CoolNamesAllTaken/kicad-libs/README.md

# kicad-libs
Custom components (symbols, footprints, 3d models) aggregated for KiCAD EDA.
