CoolNamesAllTaken/kicad-libs/stackups/jlcpcb_6layer_1.6mm_1oz_0.5oz_jlc06161h-7628.png

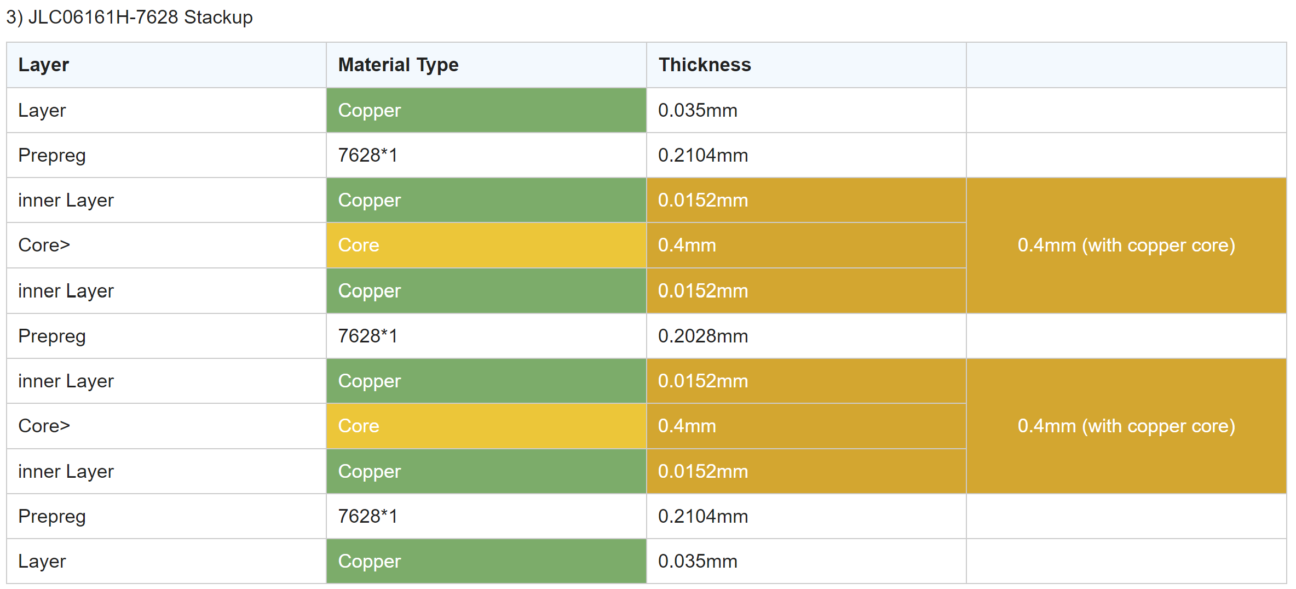
stackups/jlcpcb_6layer_1.6mm_1oz_0.5oz_jlc06161h-7628.png
