CoolNamesAllTaken/kicad-libs/lib_3d/Custom_Battery/LiPo 6060100.step

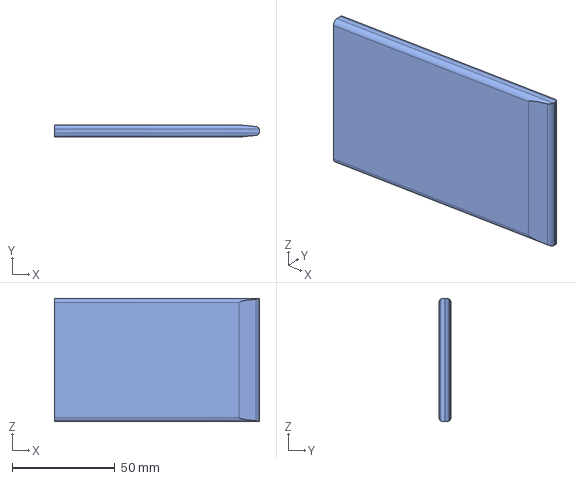
[picture p2: CAD file, 2026-04-22]
lib_3d/Custom_Battery/LiPo 6060100.step
100.0 x 6.00 x 60.0 mm
