CoolNamesAllTaken/kicad-libs/lib_3d/Custom_Button_Switch_SMD/Membrane Button Rect 3.step

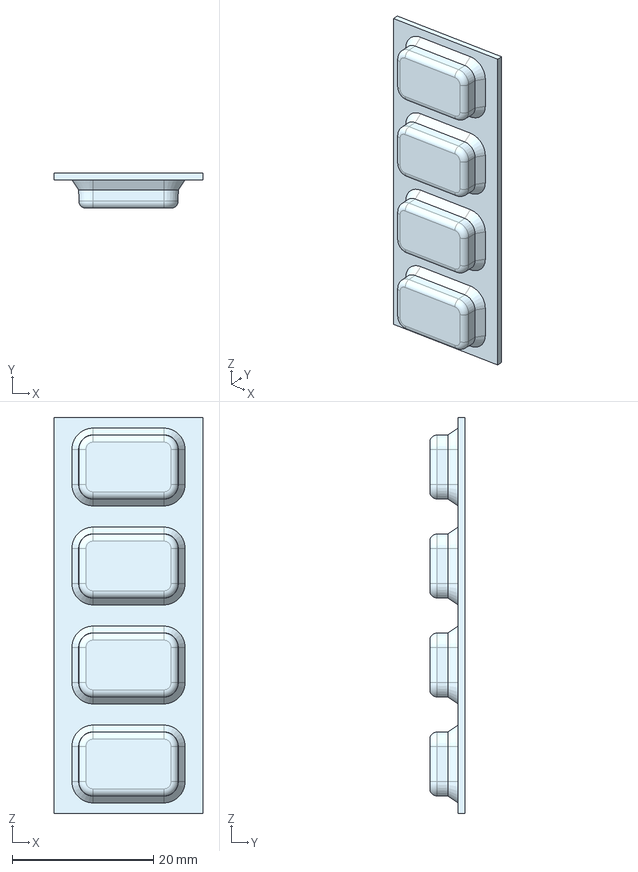
[picture p3: CAD file, 2026-04-22]
lib_3d/Custom_Button_Switch_SMD/Membrane Button Rect 3.step
21.0 x 5.00 x 56.0 mm
