CoolNamesAllTaken/kicad-libs/lib_3d/Custom_Connector/FTSH-105-01-L-DV-K.stp

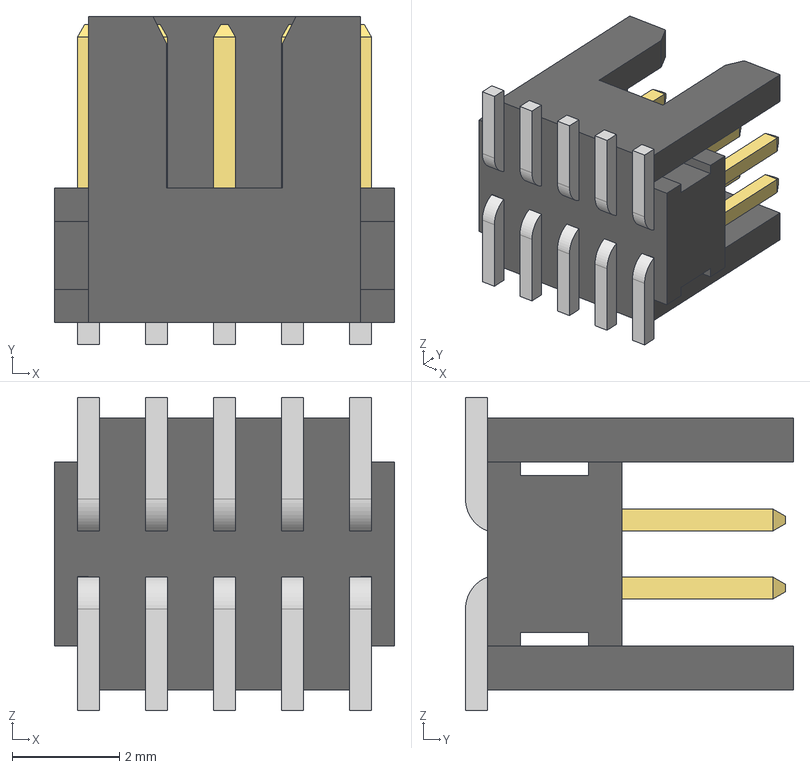
[picture p4: CAD file, 2026-06-26]
lib_3d/Custom_Connector/FTSH-105-01-L-DV-K.stp
6.35 x 6.12 x 5.84 mm
FTSH-105-01-L-DV-K_body
FTSH-105-01-L-DV-K_pins1
FTSH-105-01-L-DV-K_pins2
