CoolNamesAllTaken/kicad-libs/lib_3d/Custom_Connector_Audio/Boom_PJ-320B.step

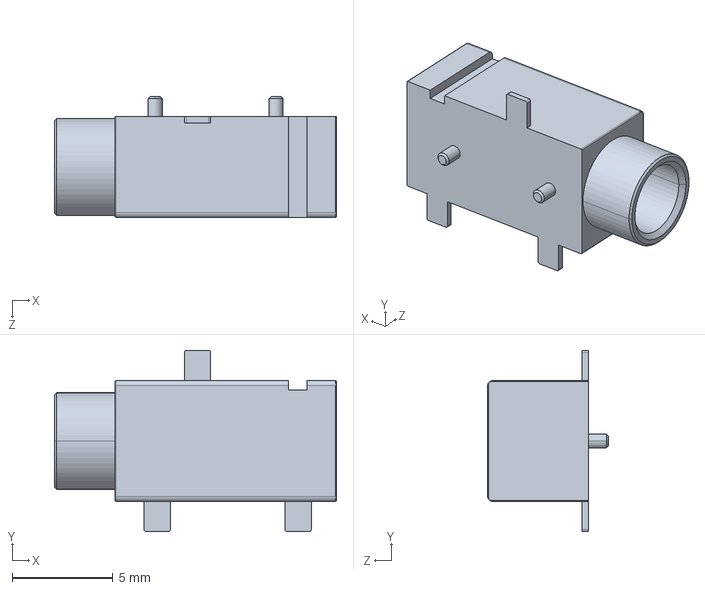
[picture p5: CAD file, 2022-11-25]
lib_3d/Custom_Connector_Audio/Boom_PJ-320B.step
14.0 x 9.00 x 6.00 mm
