CoolNamesAllTaken/kicad-libs/lib_3d/Custom_Connector_BarrelJack/SOFNG_DC005-T20.step

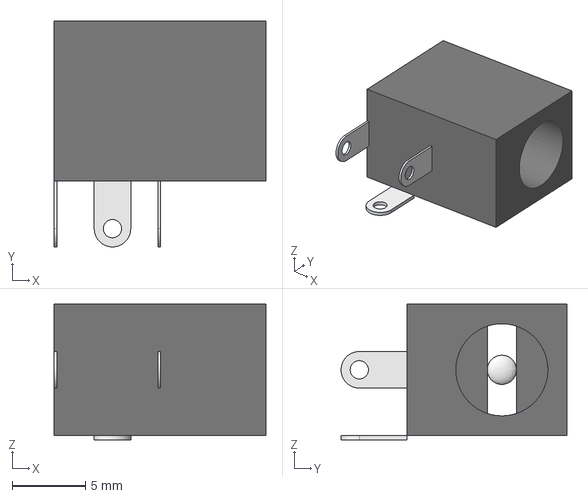
[picture p6: CAD file, 2022-11-25]
lib_3d/Custom_Connector_BarrelJack/SOFNG_DC005-T20.step
14.5 x 15.4 x 9.30 mm
