CoolNamesAllTaken/kicad-libs/lib_3d/Custom_Connector_Card/micro-sd-card-dummy.step

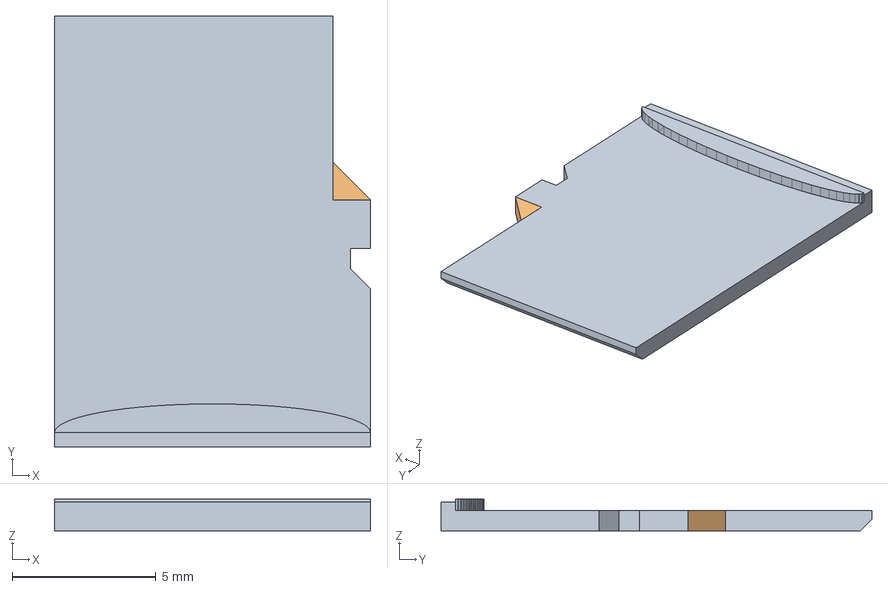
[picture p7: CAD file, 2026-04-22]
lib_3d/Custom_Connector_Card/micro-sd-card-dummy.step
11.0 x 15.0 x 1.10 mm
