CoolNamesAllTaken/kicad-libs/lib_3d/Custom_Connector_Coaxial/SMA_Amphenol_132255-11_EdgeMount.stp

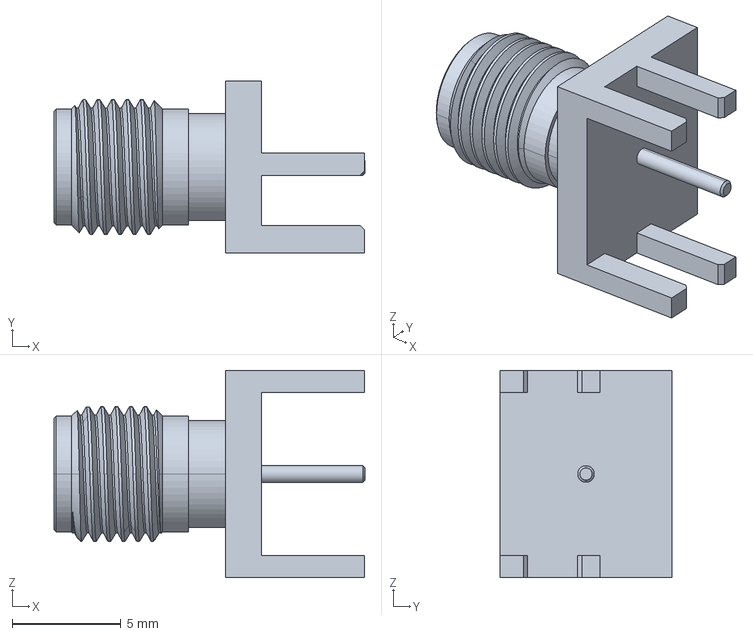
[picture p8: CAD file, 2023-06-24]
lib_3d/Custom_Connector_Coaxial/SMA_Amphenol_132255-11_EdgeMount.stp
14.3 x 7.92 x 9.52 mm
