CoolNamesAllTaken/kicad-libs/lib_3d/Custom_Connector_FFC-FPC/FPC-SMD_5P-P0.50_HCTL_HC-FPC-05-10-5RLTAG.step

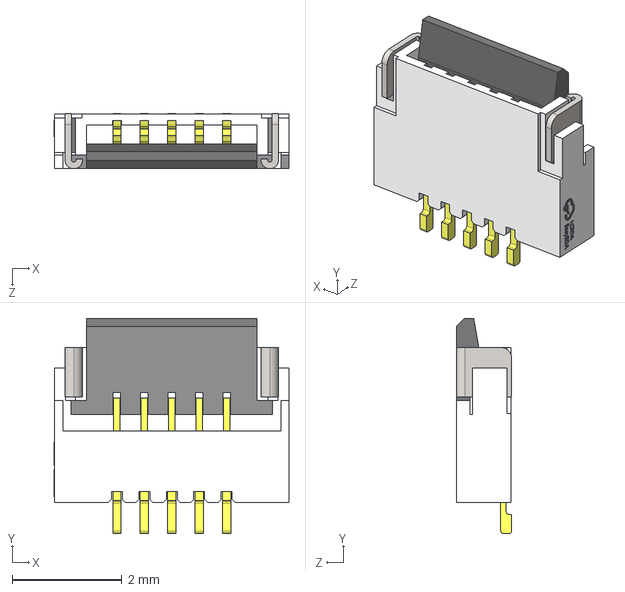
[picture p9: CAD file, 2026-05-06]
lib_3d/Custom_Connector_FFC-FPC/FPC-SMD_5P-P0.50_HCTL_HC-FPC-05-10-5RLTAG.step
4.28 x 3.92 x 1.01 mm
