CoolNamesAllTaken/kicad-libs/lib_3d/Custom_Connector_Hirose/Hirose_DF40HC(3.5)-30DS-0.4V(51)_P0.4mm_Vertical.stp

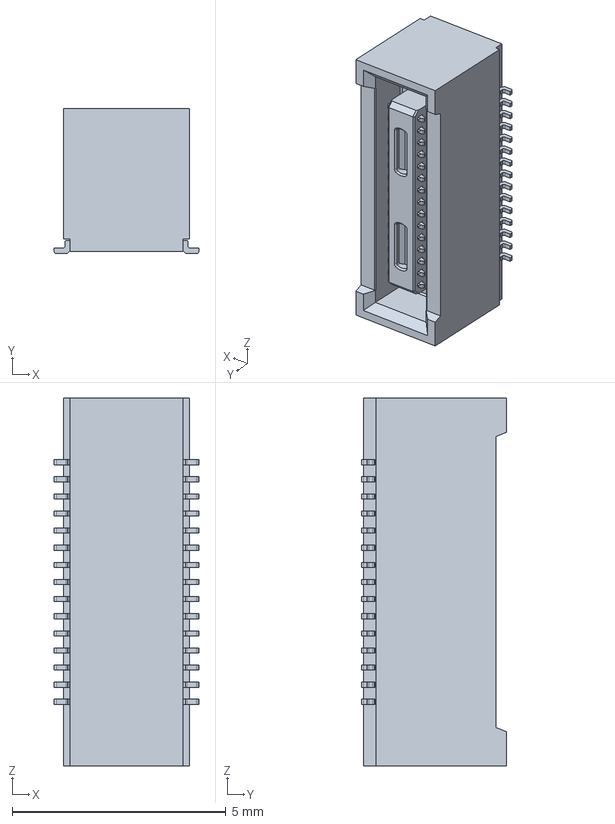
[picture p10: CAD file, 2024-07-10]
lib_3d/Custom_Connector_Hirose/Hirose_DF40HC(3.5)-30DS-0.4V(51)_P0.4mm_Vertical.stp
3.38 x 3.40 x 8.60 mm
