CoolNamesAllTaken/kicad-libs/lib_3d/Custom_Connector_JST/SM03B-PASS-TBT.step

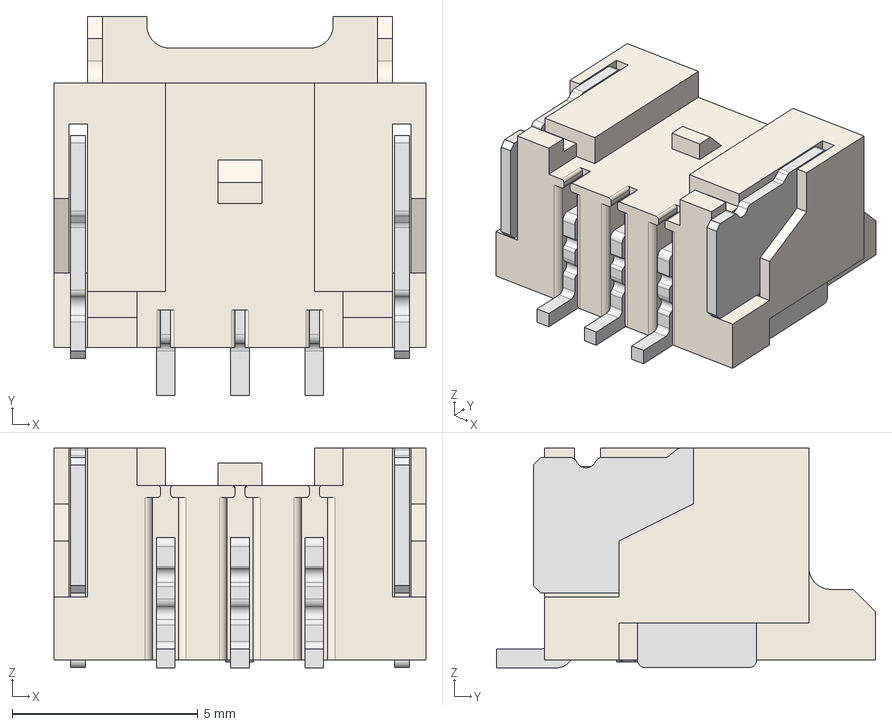
[picture p11: CAD file, 2026-04-22]
lib_3d/Custom_Connector_JST/SM03B-PASS-TBT.step
10.0 x 10.2 x 5.91 mm
CONN-SMD_SM03B-PASS-TBT~CONN-SMD_SM03B-PASS-TBT~jsbc
CONN-SMD_SM03B-PASS-TBT~CONN-SMD_SM03B-PASS-TBT~jsbc001
CONN-SMD_SM03B-PASS-TBT~CONN-SMD_SM03B-PASS-TBT~jsbc002
