CoolNamesAllTaken/kicad-libs/lib_3d/Custom_Connector_Molex/Molex_Micro-Fit_3.0_43045-0612_2x03_P3.00mm_Vertical.stp

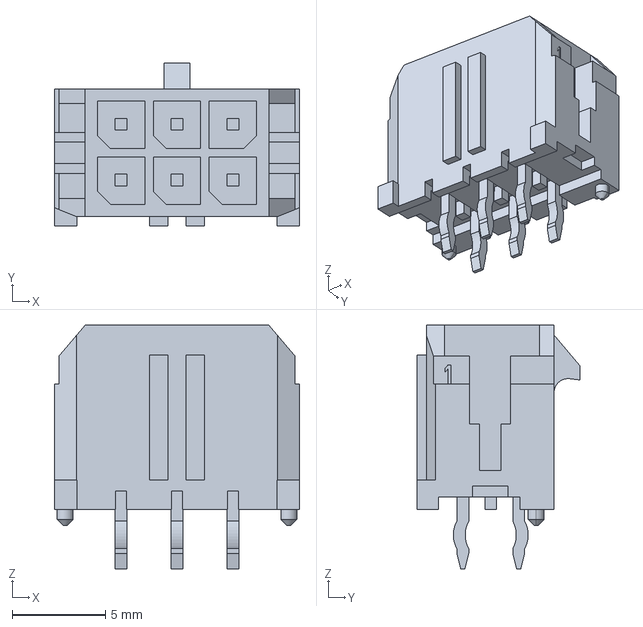
[picture p12: CAD file, 2023-06-24]
lib_3d/Custom_Connector_Molex/Molex_Micro-Fit_3.0_43045-0612_2x03_P3.00mm_Vertical.stp
13.2 x 8.77 x 13.1 mm
