CoolNamesAllTaken/kicad-libs/lib_3d/Custom_Connector_Pogo/Pogo_P75-B1_SpearHead30deg_D1mm.stp

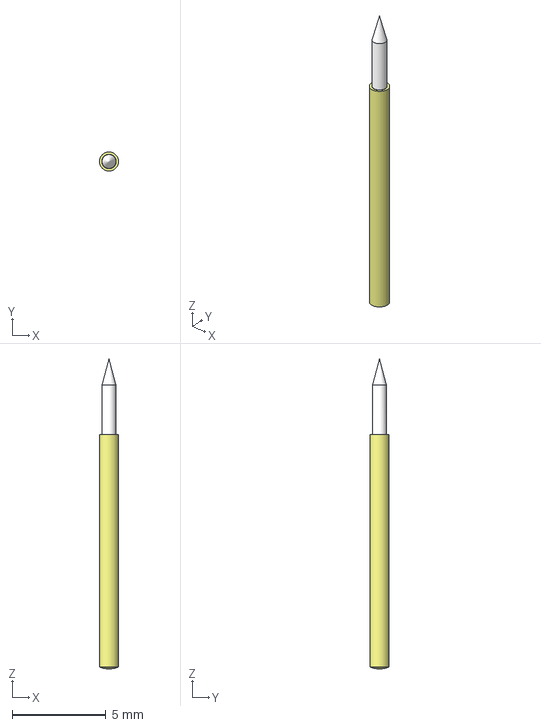
[picture p13: CAD file, 2023-11-26]
lib_3d/Custom_Connector_Pogo/Pogo_P75-B1_SpearHead30deg_D1mm.stp
1.02 x 1.02 x 16.5 mm
