CoolNamesAllTaken/kicad-libs/lib_3d/Custom_Connector_RF/Hirose_W.FL2-R-SMT-1.stp

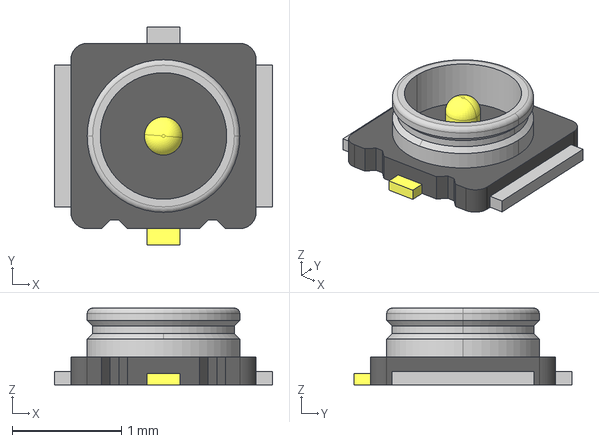
[picture p14: CAD file, 2024-08-17]
lib_3d/Custom_Connector_RF/Hirose_W.FL2-R-SMT-1.stp
2.00 x 2.00 x 0.705 mm
