CoolNamesAllTaken/kicad-libs/lib_3d/Custom_Connector_RJ/HanRun_HY931147C.step

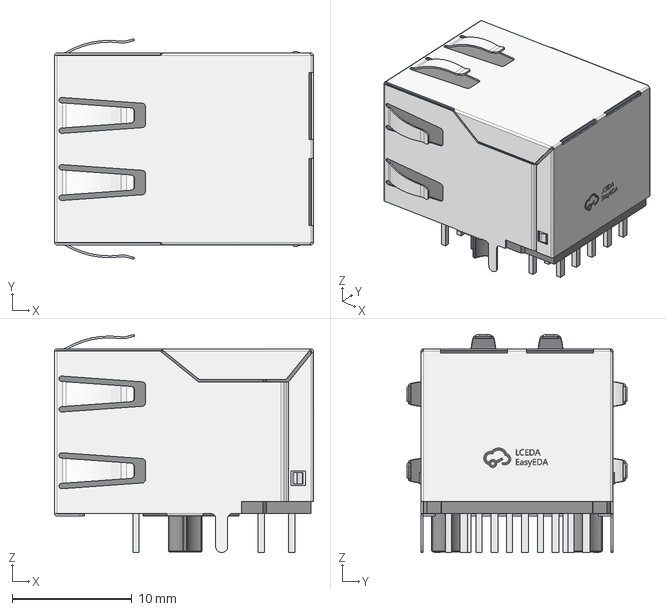
[picture p15: CAD file, 2024-07-20]
lib_3d/Custom_Connector_RJ/HanRun_HY931147C.step
21.6 x 18.4 x 18.2 mm
