CoolNamesAllTaken/kicad-libs/lib_3d/Custom_Connector_USB/USB4105-GF-A.STEP

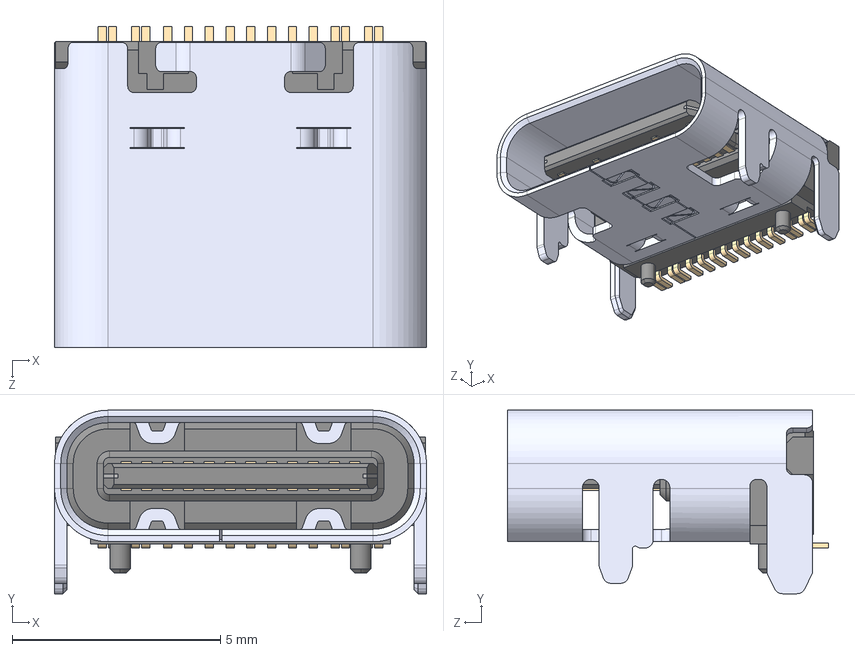
[picture p16: CAD file, 2026-04-22]
lib_3d/Custom_Connector_USB/USB4105-GF-A.STEP
8.94 x 4.41 x 7.71 mm
