CoolNamesAllTaken/kicad-libs/lib_3d/Custom_Crystal/Crystal_SMD_2016-4Pin_2.0x1.6mm.step

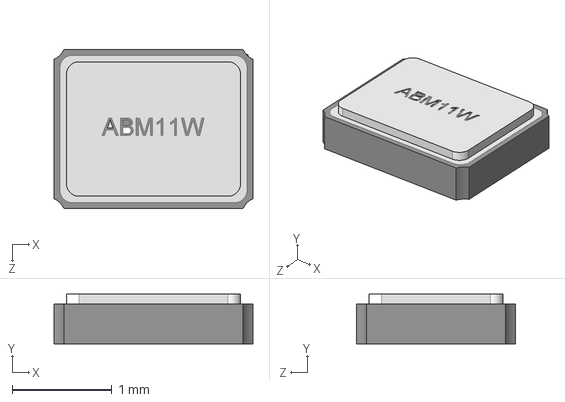
[picture p17: CAD file, 2025-05-04]
lib_3d/Custom_Crystal/Crystal_SMD_2016-4Pin_2.0x1.6mm.step
2.00 x 0.5 x 1.60 mm
