CoolNamesAllTaken/kicad-libs/lib_3d/Custom_Diode/D_PowerDI-5.stp

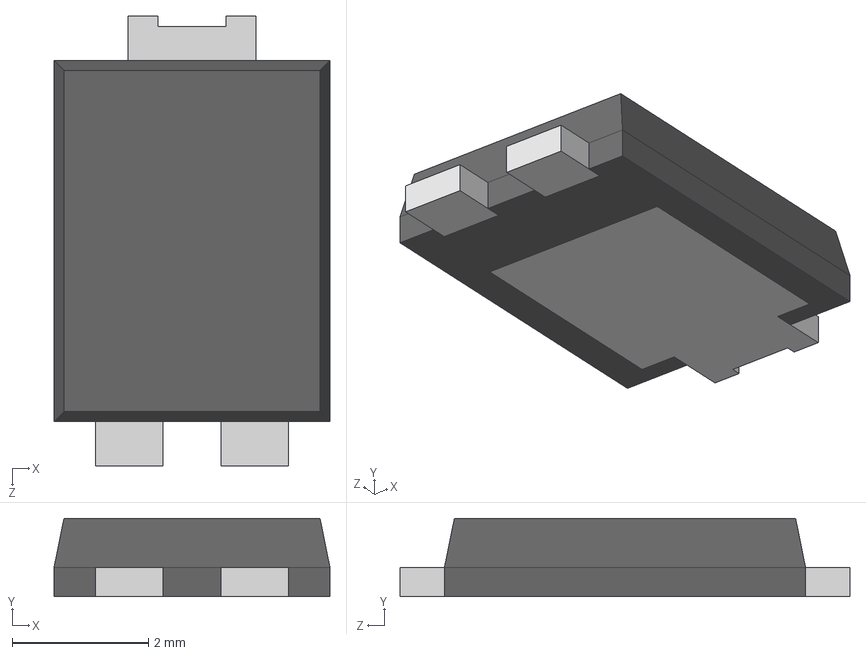
[picture p18: CAD file, 2023-06-24]
lib_3d/Custom_Diode/D_PowerDI-5.stp
4.05 x 1.15 x 6.60 mm
