CoolNamesAllTaken/kicad-libs/lib_3d/Custom_Diode_TVS/ESD_TVS_0402_1005Metric.stp

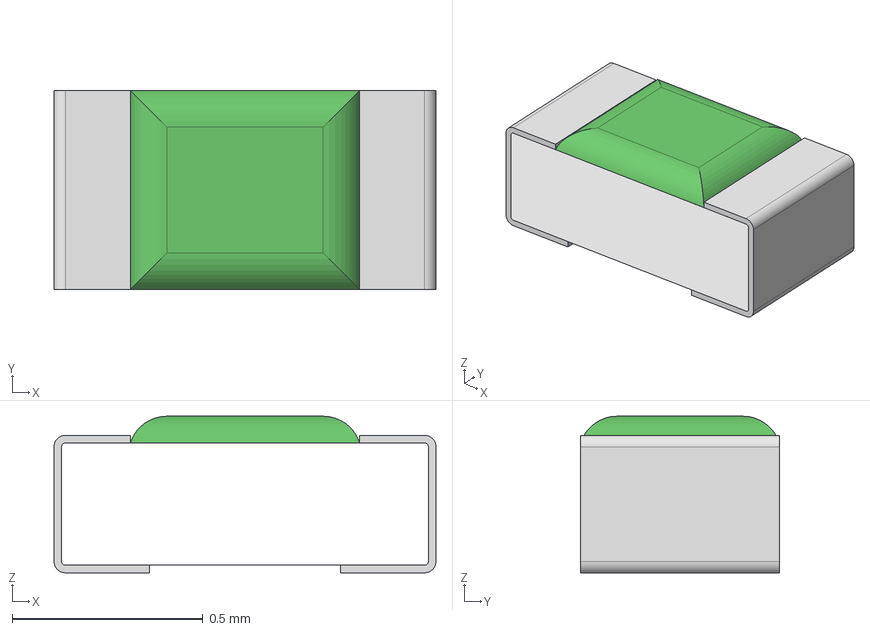
[picture p19: CAD file, 2023-06-24]
lib_3d/Custom_Diode_TVS/ESD_TVS_0402_1005Metric.stp
1.00 x 0.52 x 0.41 mm
contacs x 2
ceramic substrate
Over Coat
