CoolNamesAllTaken/kicad-libs/lib_3d/Custom_Display/GDEY027T91-FL02.step

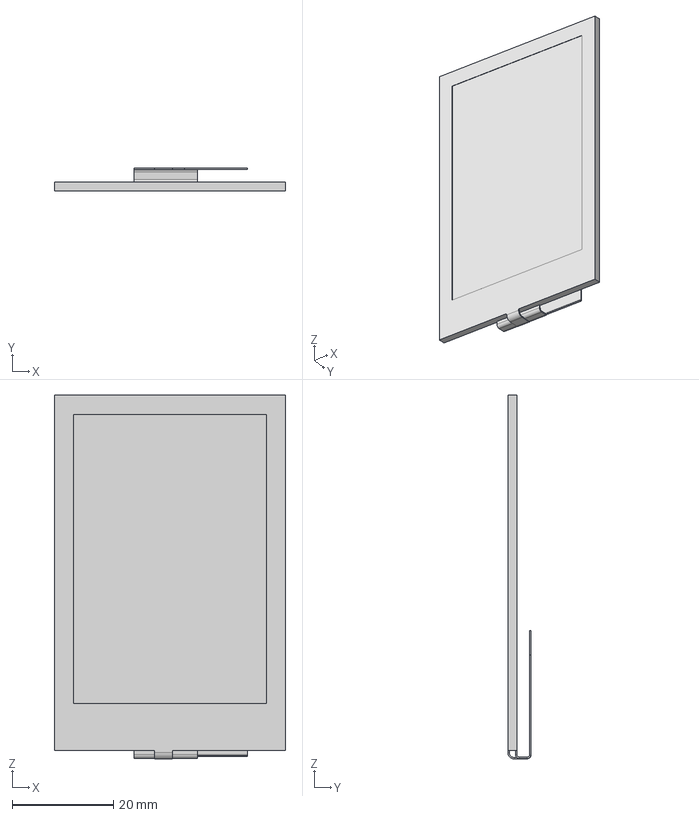
[picture p20: CAD file, 2026-05-08]
lib_3d/Custom_Display/GDEY027T91-FL02.step
45.8 x 4.65 x 72.1 mm
