CoolNamesAllTaken/kicad-libs/lib_3d/Custom_Filter/Filter_SAW-6_3.0x3.0mm.step

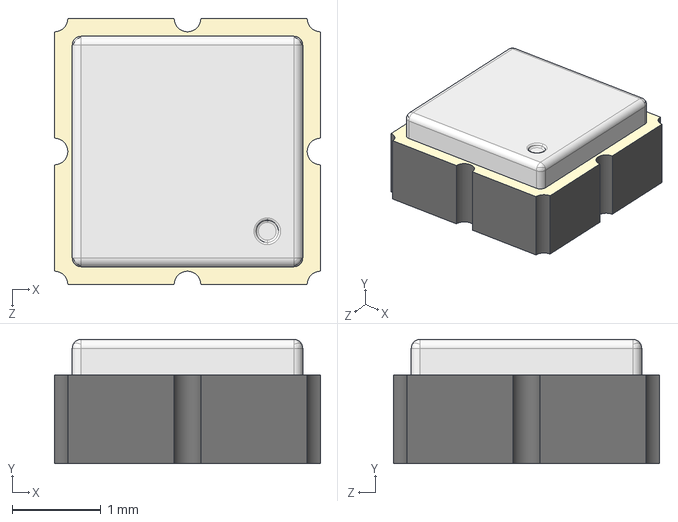
[picture p21: CAD file, 2024-07-10]
lib_3d/Custom_Filter/Filter_SAW-6_3.0x3.0mm.step
3.00 x 1.40 x 3.00 mm
