CoolNamesAllTaken/kicad-libs/lib_3d/Custom_Fuse/Fuse_BelFuse_0679L.stp

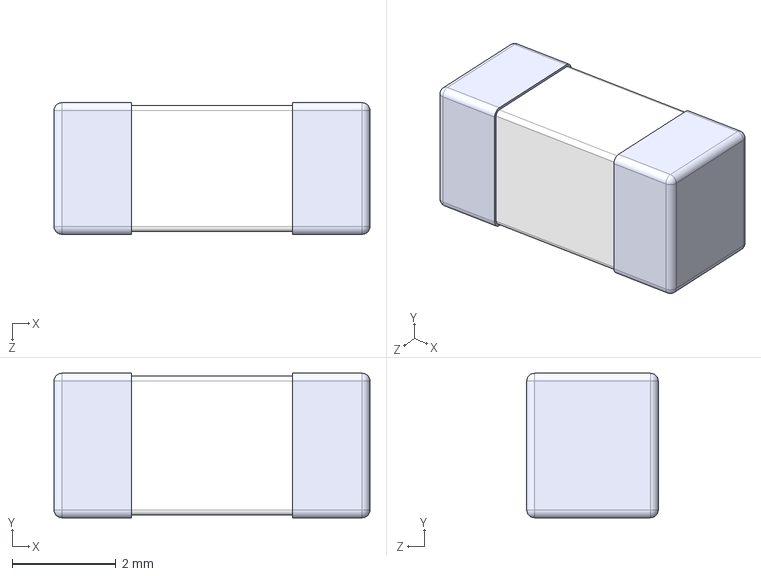
[picture p22: CAD file, 2023-06-24]
lib_3d/Custom_Fuse/Fuse_BelFuse_0679L.stp
6.10 x 2.79 x 2.54 mm
