CoolNamesAllTaken/kicad-libs/lib_3d/Custom_Inductor/L_SunItechTech_SLO1040H470MTT.stp

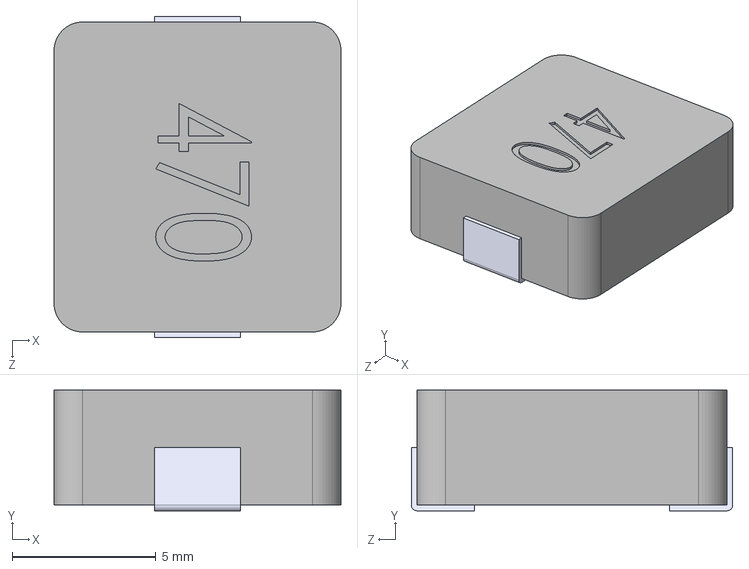
[picture p23: CAD file, 2023-07-08]
lib_3d/Custom_Inductor/L_SunItechTech_SLO1040H470MTT.stp
10.0 x 4.20 x 11.2 mm
