CoolNamesAllTaken/kicad-libs/lib_3d/Custom_LED_SMD/LED-SMD_4P-L2.0-W2.0-H0.8-TL_WS2812B-2020.step

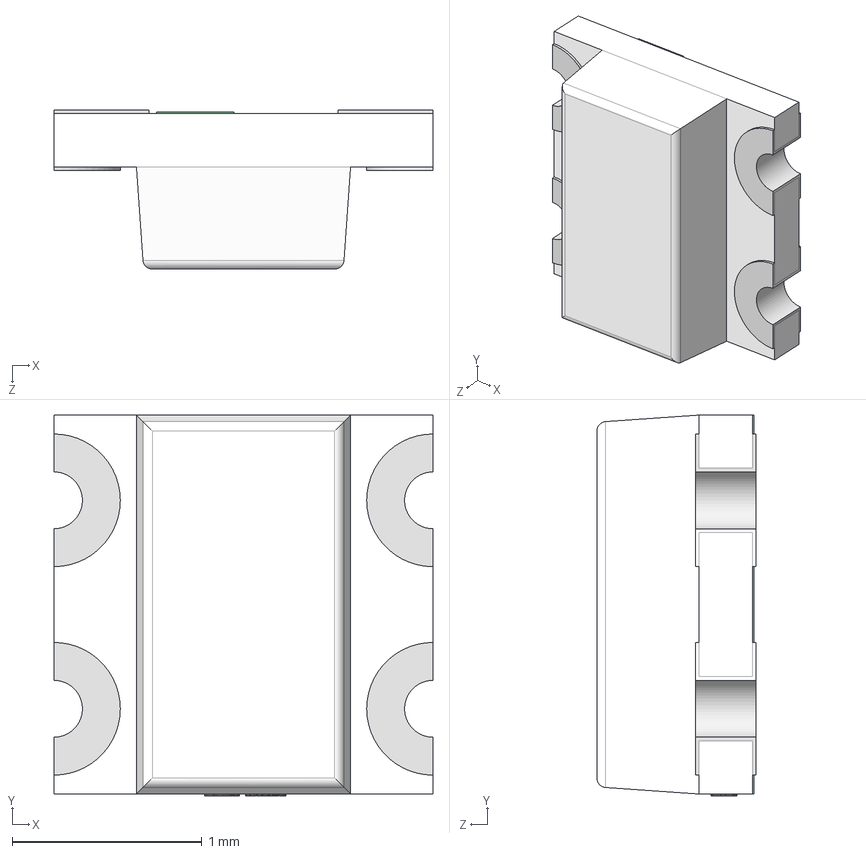
[picture p24: CAD file, 2026-04-22]
lib_3d/Custom_LED_SMD/LED-SMD_4P-L2.0-W2.0-H0.8-TL_WS2812B-2020.step
2.00 x 2.01 x 0.84 mm
