CoolNamesAllTaken/kicad-libs/lib_3d/Custom_MCU_Espressif/ESP32-S3-MINI-1U.step

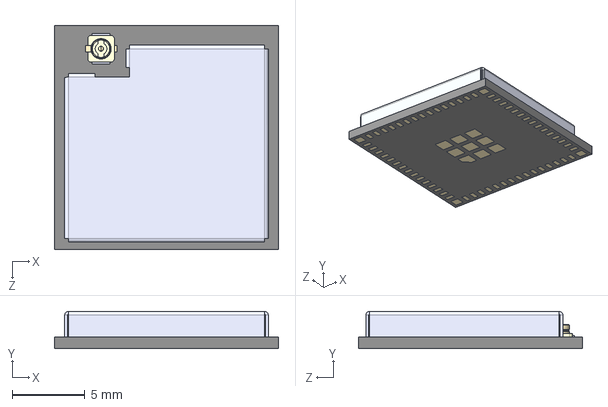
[picture p25: CAD file, 2024-07-10]
lib_3d/Custom_MCU_Espressif/ESP32-S3-MINI-1U.step
15.4 x 2.55 x 15.4 mm
ESP32-S3-MINI-1U-N8_ESP32-C3-MINI-1-N4
antenna jack
