CoolNamesAllTaken/kicad-libs/lib_3d/Custom_Module/adsbee_m1090_simplified.step

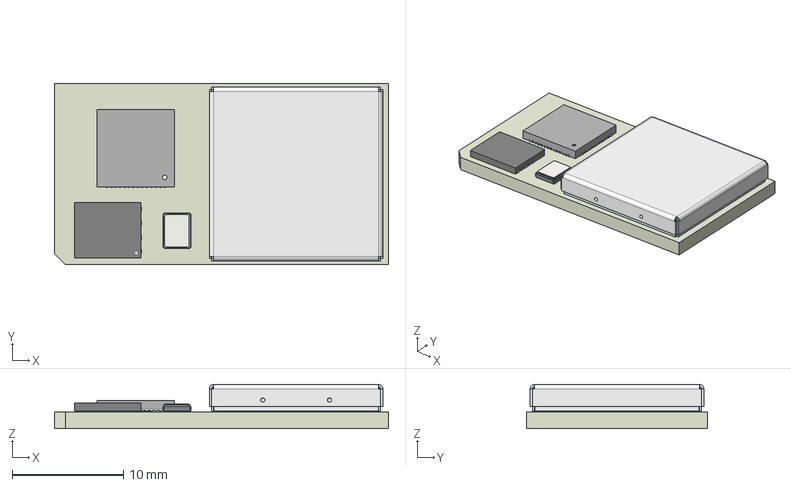
[picture p26: CAD file, 2026-05-08]
lib_3d/Custom_Module/adsbee_m1090_simplified.step
30.0 x 16.3 x 3.97 mm
PantsForBirds_PFB148-20F
PantsForBIrds_PFB148-20C
QFN-56-1EP_7x7mm_P0.4mm_EP3.2x3.2mm
WSON-8-1EP_6x5mm_P1.27mm_EP3.4x4.3mm
Crystal_SMD_3225-4Pin_3.2x2.5mm
adsbee_m1090_PCB
