CoolNamesAllTaken/kicad-libs/lib_3d/Custom_Mounting/Sinhoo_SMTSO2550.step

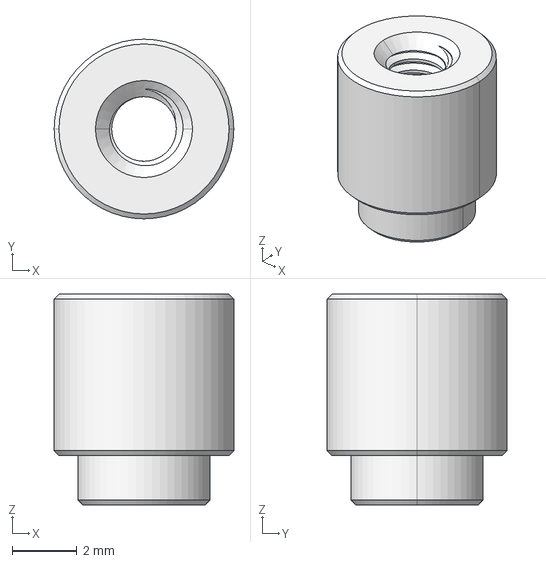
[picture p27: CAD file, 2026-04-22]
lib_3d/Custom_Mounting/Sinhoo_SMTSO2550.step
5.56 x 5.56 x 6.53 mm
