CoolNamesAllTaken/kicad-libs/lib_3d/Custom_OptoDevice/LTR-329ALS-01_LTO.step

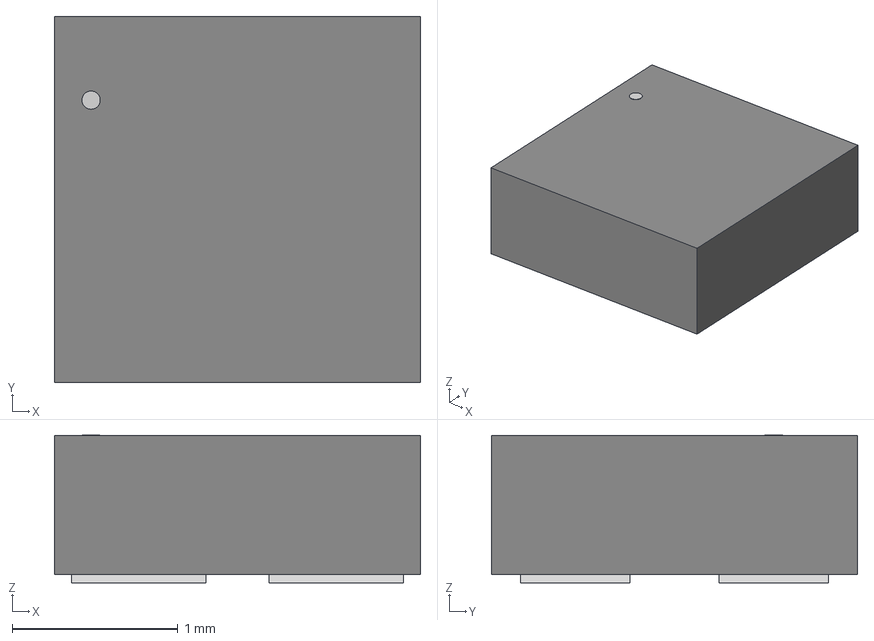
[picture p28: CAD file, 2026-04-22]
lib_3d/Custom_OptoDevice/LTR-329ALS-01_LTO.step
2.21 x 2.21 x 0.892 mm
