CoolNamesAllTaken/kicad-libs/lib_3d/Custom_Package_BGA/DSBGA9-YZF_TEX.step

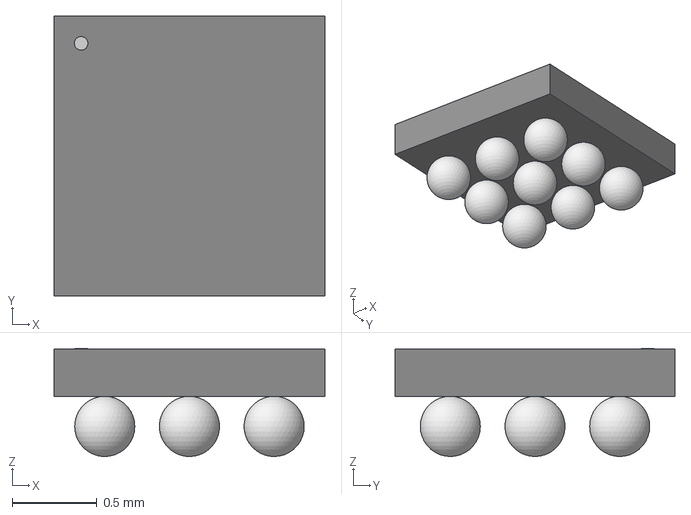
[picture p29: CAD file, 2026-04-22]
lib_3d/Custom_Package_BGA/DSBGA9-YZF_TEX.step
1.60 x 1.65 x 0.638 mm
