CoolNamesAllTaken/kicad-libs/lib_3d/Custom_Package_CSP/LFCSP-8-23_2x3mm_P0.5mm_EP0.45x1.74mm.stp

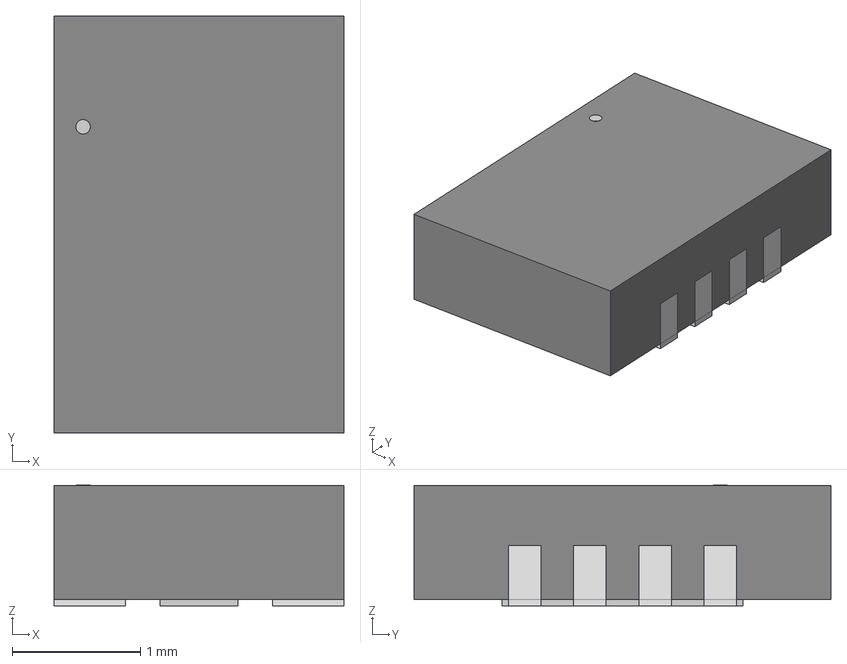
[picture p30: CAD file, 2023-06-24]
lib_3d/Custom_Package_CSP/LFCSP-8-23_2x3mm_P0.5mm_EP0.45x1.74mm.stp
2.26 x 3.25 x 0.942 mm
