CoolNamesAllTaken/kicad-libs/lib_3d/Custom_Package_DFN_QFN/UMLP16_1P8X2P6_ONS.step

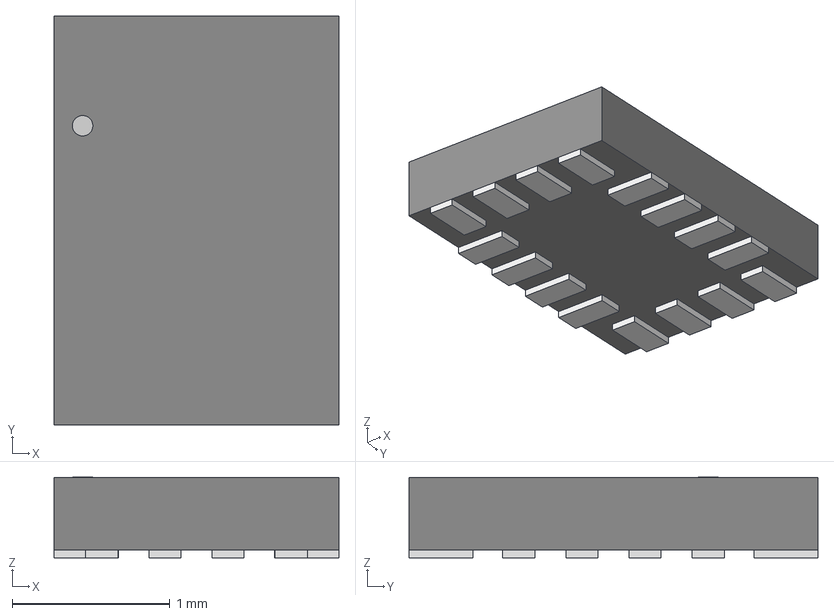
[picture p31: CAD file, 2026-04-22]
lib_3d/Custom_Package_DFN_QFN/UMLP16_1P8X2P6_ONS.step
1.80 x 2.59 x 0.511 mm
