CoolNamesAllTaken/kicad-libs/lib_3d/Custom_Package_SO/SOIC-8_5.23x5.23mm_P1.27mm.step

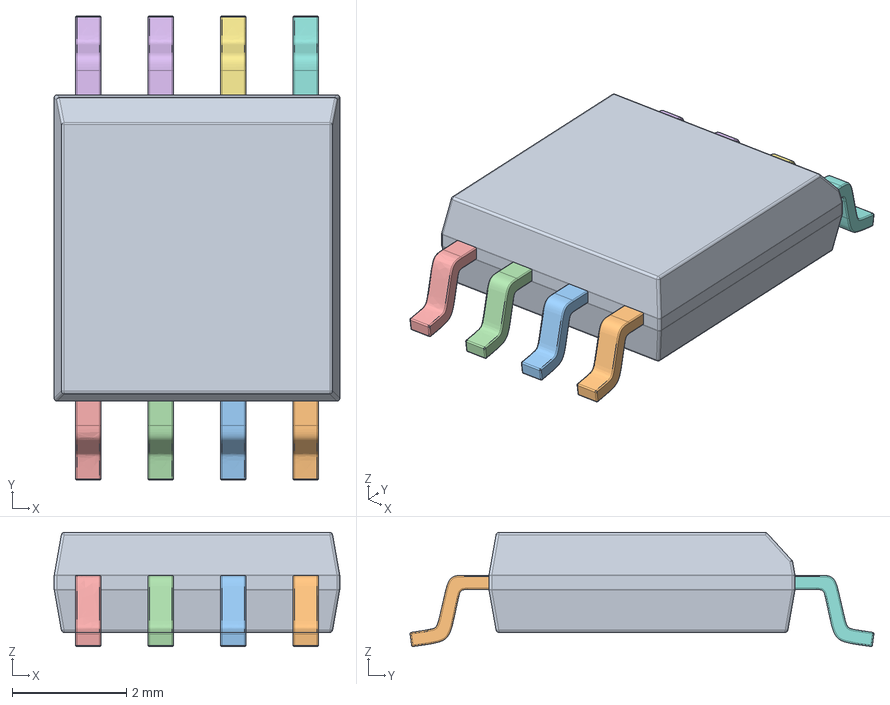
[picture p32: CAD file, 2024-07-10]
lib_3d/Custom_Package_SO/SOIC-8_5.23x5.23mm_P1.27mm.step
5.00 x 8.12 x 2.00 mm
