CoolNamesAllTaken/kicad-libs/lib_3d/Custom_Potentiometer_THT/Potentiometer_Alps_RK163_Single_Horizontal.STEP

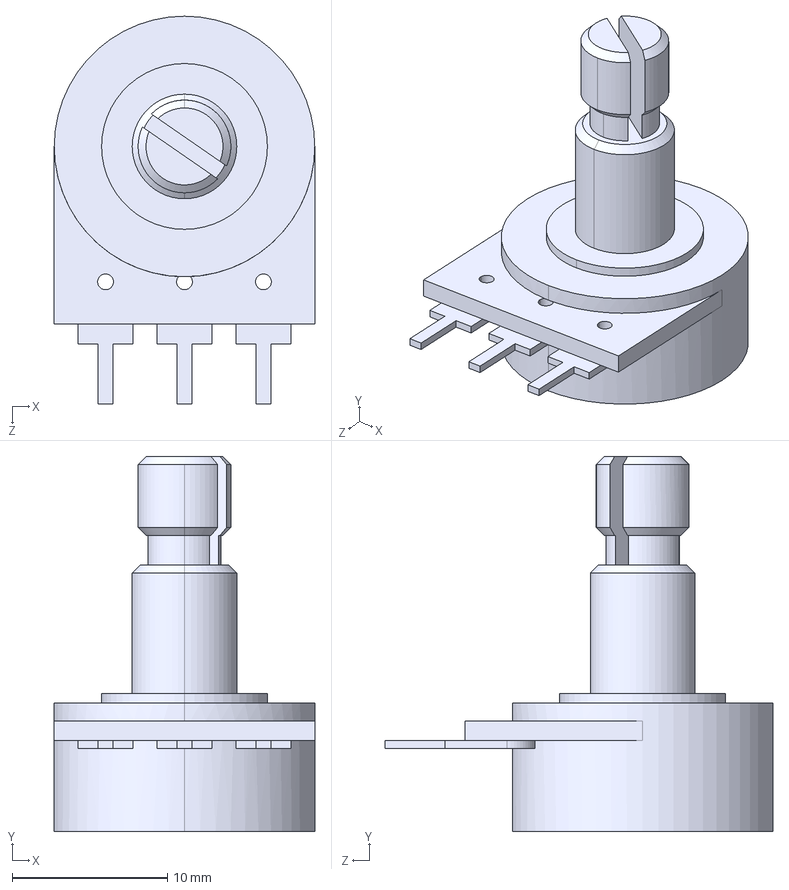
[picture p33: CAD file, 2023-06-24]
lib_3d/Custom_Potentiometer_THT/Potentiometer_Alps_RK163_Single_Horizontal.STEP
16.8 x 24.1 x 24.9 mm
