CoolNamesAllTaken/kicad-libs/lib_3d/Custom_RF_Shielding/PantsForBirds_PFB148-20.step

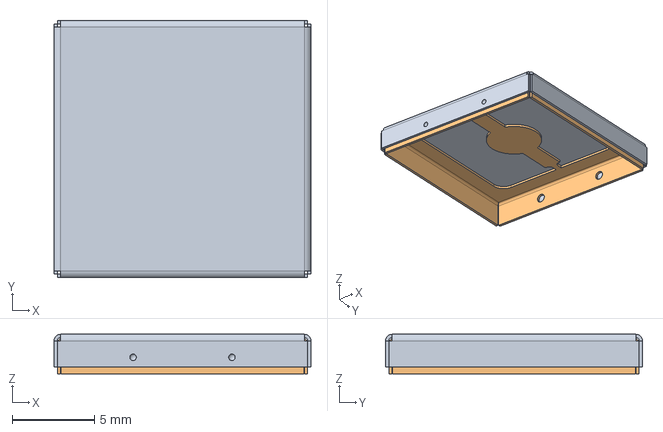
[picture p34: CAD file, 2025-03-28]
lib_3d/Custom_RF_Shielding/PantsForBirds_PFB148-20.step
15.6 x 15.6 x 2.40 mm
