CoolNamesAllTaken/kicad-libs/lib_3d/Custom_Sensor/FC-CO-5000.stp

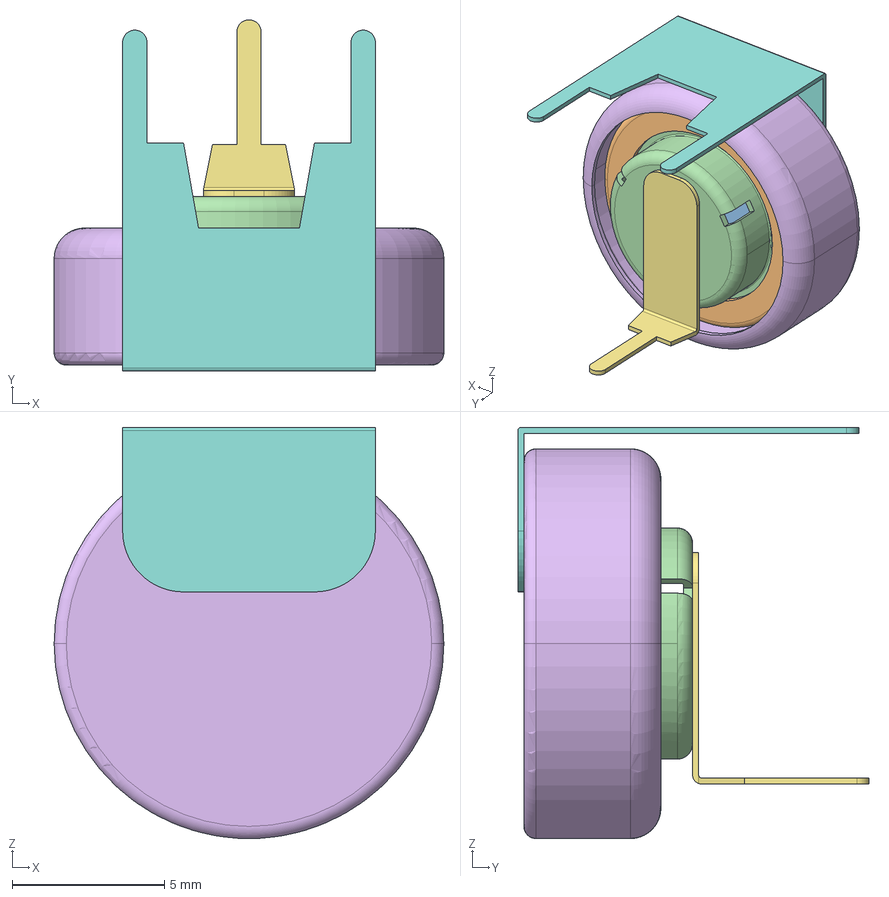
[picture p35: CAD file, 2026-04-22]
lib_3d/Custom_Sensor/FC-CO-5000.stp
12.8 x 11.5 x 13.5 mm
