CoolNamesAllTaken/kicad-libs/lib_3d/Custom_TestJack/Keystone_5015_Micro-Minature.step

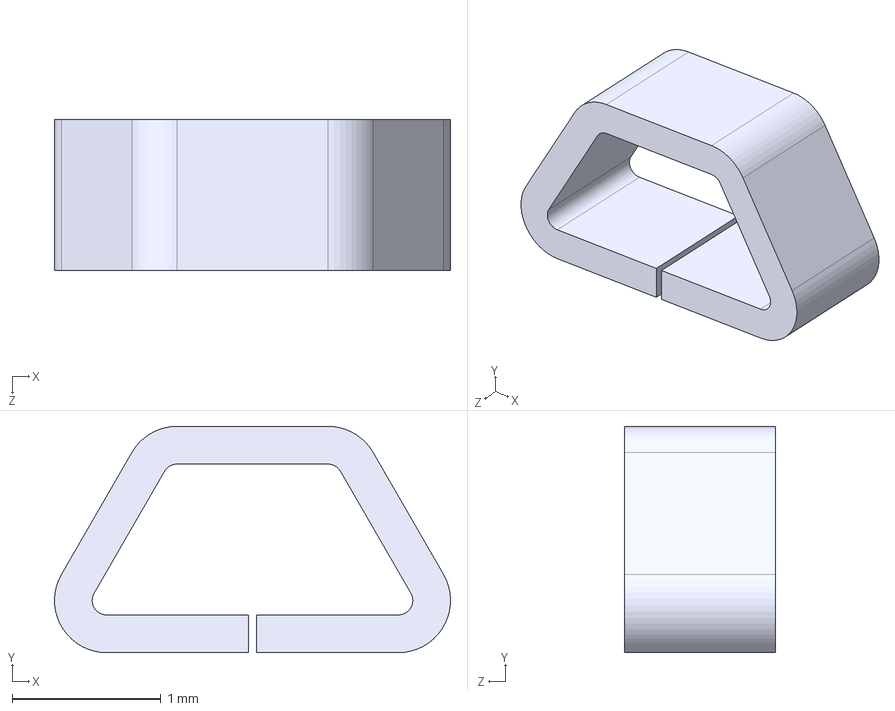
[picture p36: CAD file, 2025-01-05]
lib_3d/Custom_TestJack/Keystone_5015_Micro-Minature.step
2.67 x 1.52 x 1.02 mm
