CoolNamesAllTaken/kicad-libs/lib_3d/Custom_Transformer_SMD/XFMR-SMD_H1102NLT.step

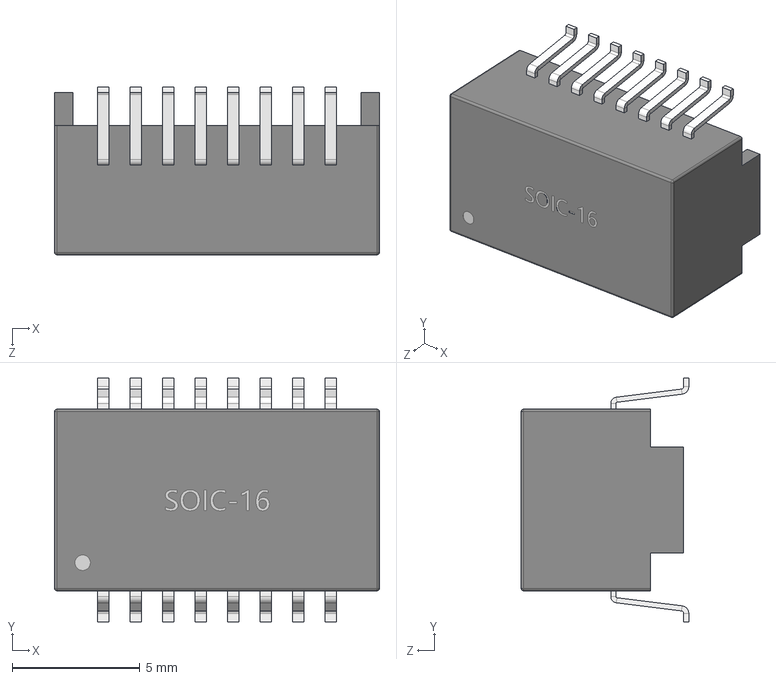
[picture p37: CAD file, 2024-07-20]
lib_3d/Custom_Transformer_SMD/XFMR-SMD_H1102NLT.step
12.7 x 9.53 x 6.55 mm
