CoolNamesAllTaken/kicad-libs/lib_3d/Custom_Button_Switch_SMD/SW-SMD_L3.9-W2.9-H2.0-LS4.8.step

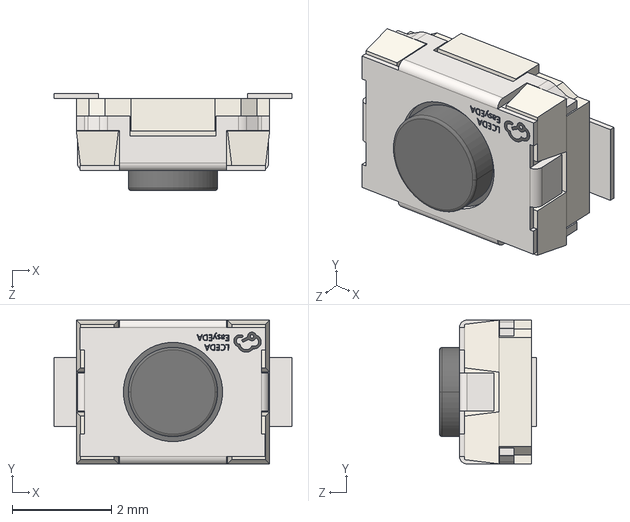
[picture p38: CAD file, 2024-07-16]
lib_3d/Custom_Button_Switch_SMD/SW-SMD_L3.9-W2.9-H2.0-LS4.8.step
4.80 x 2.90 x 1.95 mm
