CoolNamesAllTaken/kicad-libs/lib_3d/Custom_Connector/SIBF-18-F-S-AB.stp

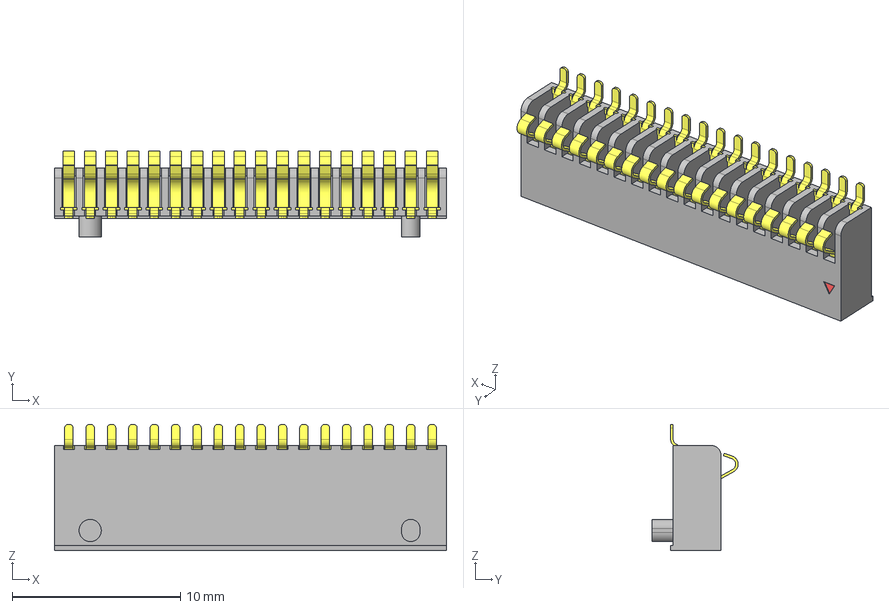
[picture p39: CAD file, 2026-06-26]
lib_3d/Custom_Connector/SIBF-18-F-S-AB.stp
23.3 x 5.13 x 7.49 mm
SIBF-18-F-S-AB_b
SIBF-18-F-S-AB_p
SIBF-18-F-S-AB_tr
