CoolNamesAllTaken/kicad-libs/lib_3d/Custom_Connector_Coaxial/SMA_Amphenol_132289_EdgeMount.stp

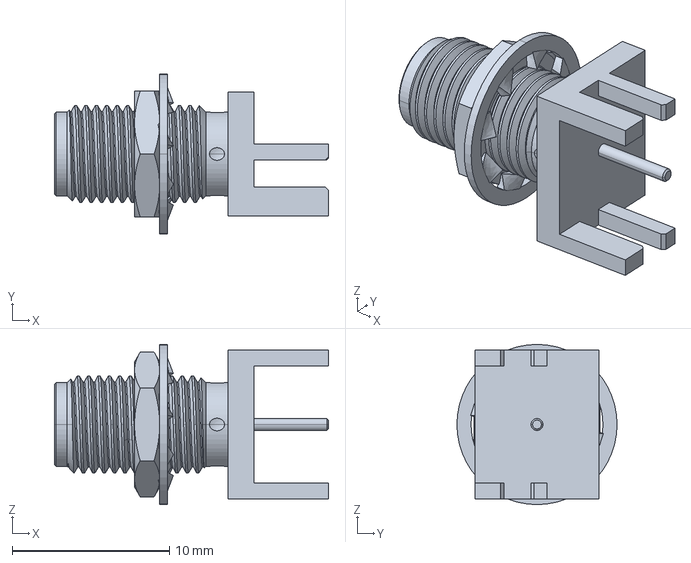
[picture p40: CAD file, 2023-06-24]
lib_3d/Custom_Connector_Coaxial/SMA_Amphenol_132289_EdgeMount.stp
17.4 x 10.2 x 10.2 mm
