CoolNamesAllTaken/kicad-libs/lib_3d/Custom_Connector_FFC-FPC/Hirose_FH34SRJ-6S-0.5SH_1x6-1MP_P0.50mm_Horizontal.stp

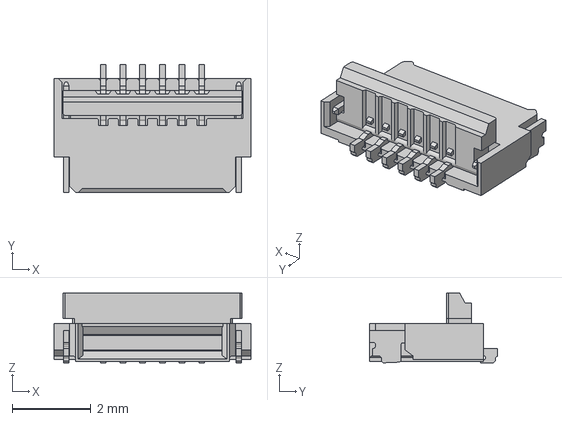
[picture p41: CAD file, 2026-04-22]
lib_3d/Custom_Connector_FFC-FPC/Hirose_FH34SRJ-6S-0.5SH_1x6-1MP_P0.50mm_Horizontal.stp
5.00 x 3.25 x 1.77 mm
