CoolNamesAllTaken/kicad-libs/lib_3d/Custom_Connector_Hirose/Hirose_DF40C-30DP-0.4V(51)_2x15_P0.40mm_Vertical.stp

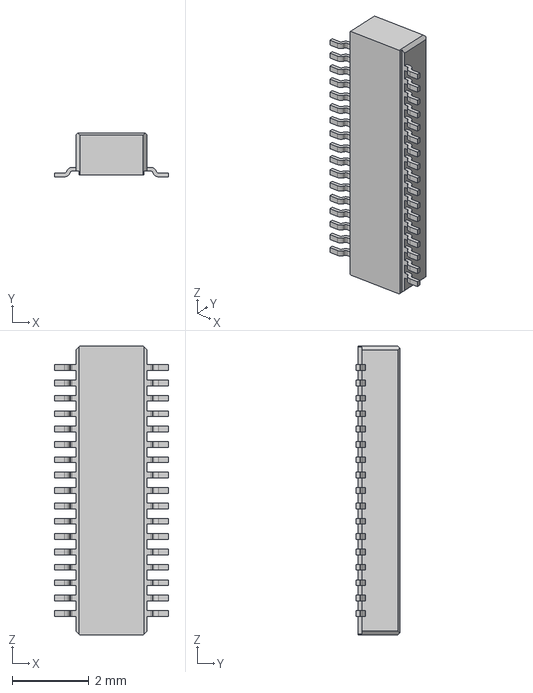
[picture p42: CAD file, 2024-07-10]
lib_3d/Custom_Connector_Hirose/Hirose_DF40C-30DP-0.4V(51)_2x15_P0.40mm_Vertical.stp
2.97 x 1.14 x 7.52 mm
