CoolNamesAllTaken/kicad-libs/lib_3d/Custom_Connector_JST/JST_SH_BM03B-SRSS-TB_1x03-1MP_P1.00mm_Vertical.step

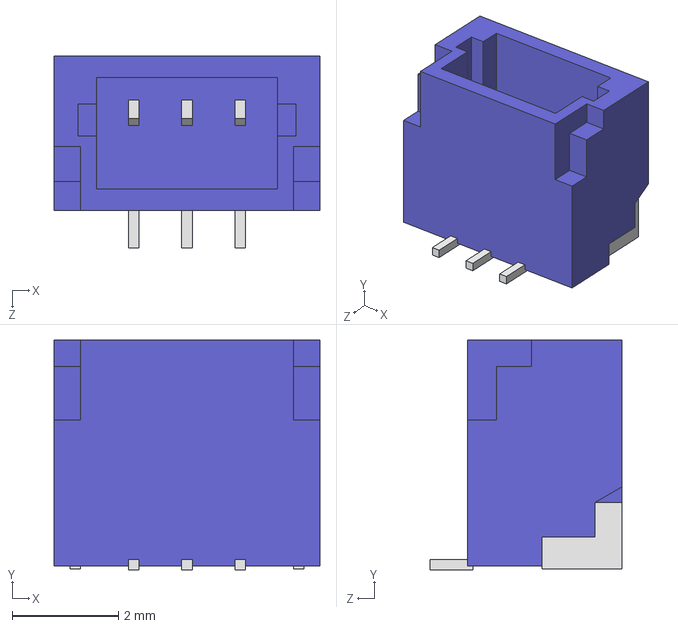
[picture p43: CAD file, 2024-08-17]
lib_3d/Custom_Connector_JST/JST_SH_BM03B-SRSS-TB_1x03-1MP_P1.00mm_Vertical.step
5.00 x 4.32 x 3.60 mm
