CoolNamesAllTaken/kicad-libs/lib_3d/Custom_Connector_RF/Hirose_U.FL-R-SMT-1.stp

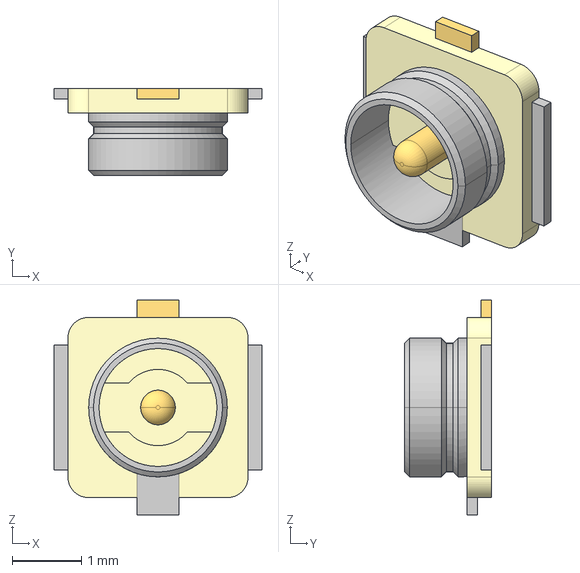
[picture p44: CAD file, 2023-06-24]
lib_3d/Custom_Connector_RF/Hirose_U.FL-R-SMT-1.stp
3.00 x 1.25 x 3.10 mm
