CoolNamesAllTaken/kicad-libs/lib_3d/Custom_Connector_RJ/RCH_RC01812.step

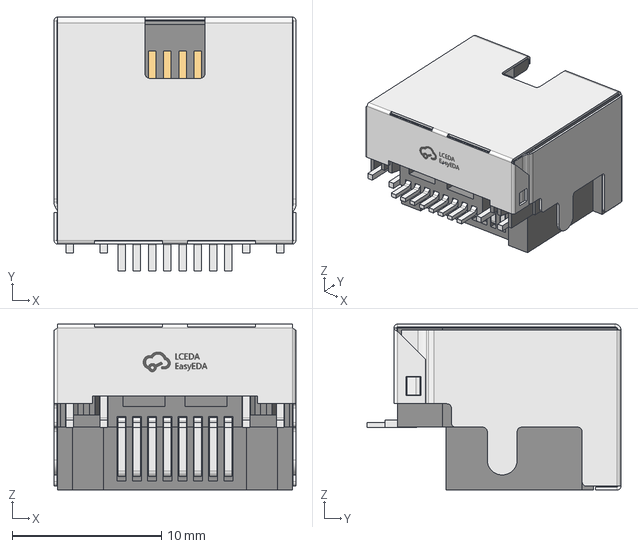
[picture p45: CAD file, 2024-07-20]
lib_3d/Custom_Connector_RJ/RCH_RC01812.step
16.2 x 17.0 x 11.1 mm
PRT0003
PRT0002
