CoolNamesAllTaken/kicad-libs/lib_3d/Custom_Connector_USB/USB_A_Wuerth_61400826021_Horizontal_Stacked.stp

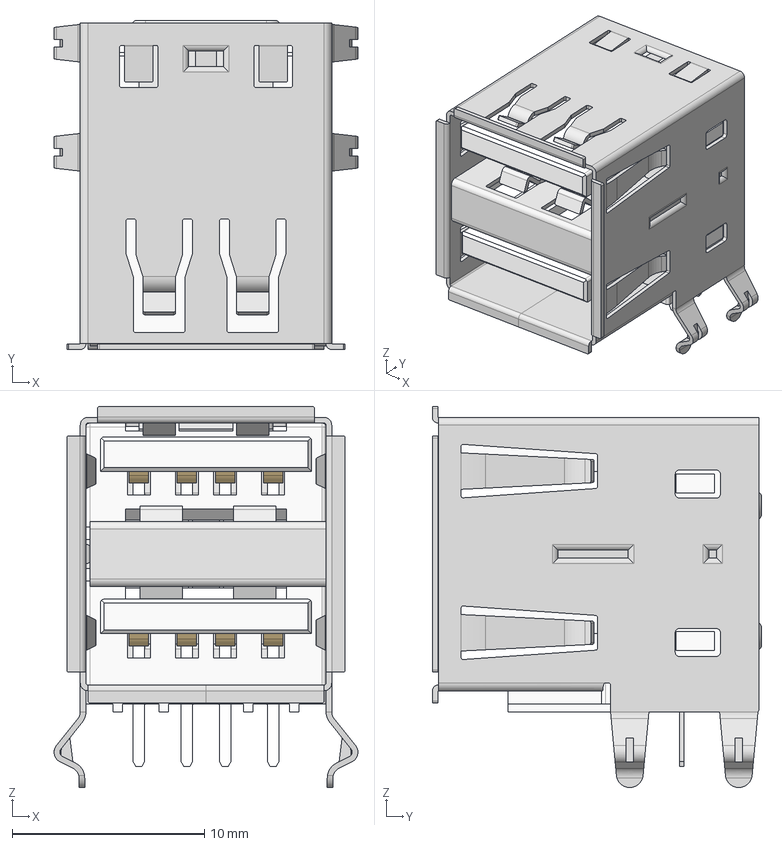
[picture p46: CAD file, 2023-06-24]
lib_3d/Custom_Connector_USB/USB_A_Wuerth_61400826021_Horizontal_Stacked.stp
15.8 x 17.1 x 19.8 mm
61400826021_Shielding1
61400826021_Housing
61400826021_Shielding2
61400826021_Pin2 x 4
61400826021_Pin1 x 4
61400826021_Shielding3
