CoolNamesAllTaken/kicad-libs/lib_3d/Custom_Diode/SOD-128.stp

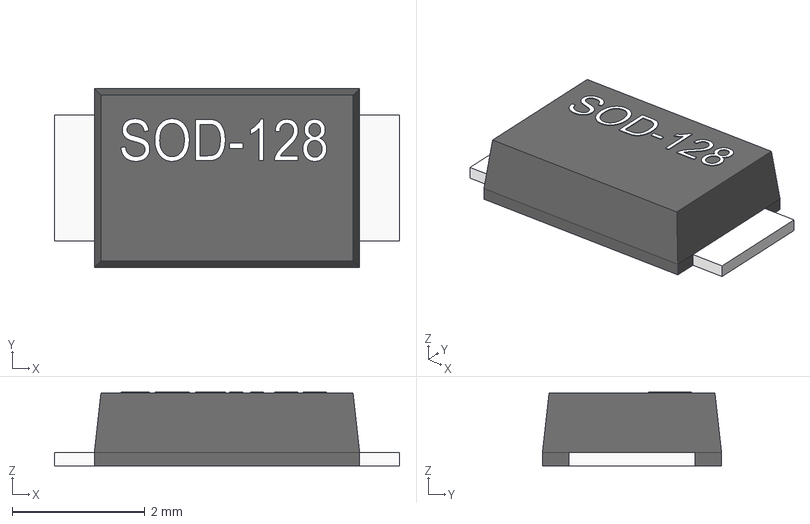
[picture p47: CAD file, 2023-06-24]
lib_3d/Custom_Diode/SOD-128.stp
5.20 x 2.70 x 1.11 mm
