CoolNamesAllTaken/kicad-libs/lib_3d/Custom_Diode_TVS/Panasonic_ZNR-VF.stp

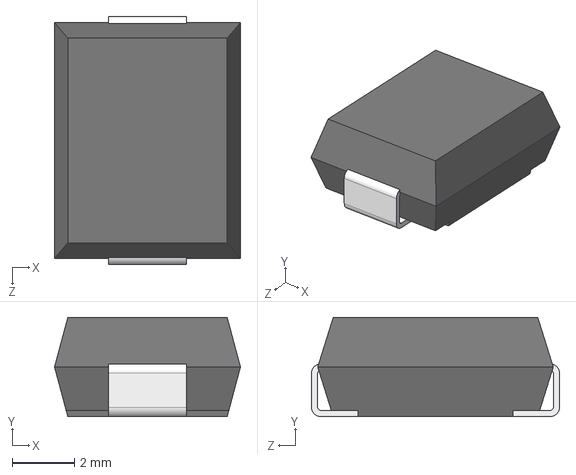
[picture p48: CAD file, 2023-06-24]
lib_3d/Custom_Diode_TVS/Panasonic_ZNR-VF.stp
6.00 x 3.20 x 8.00 mm
