CoolNamesAllTaken/kicad-libs/lib_3d/Custom_Display/GDEY027T91.step

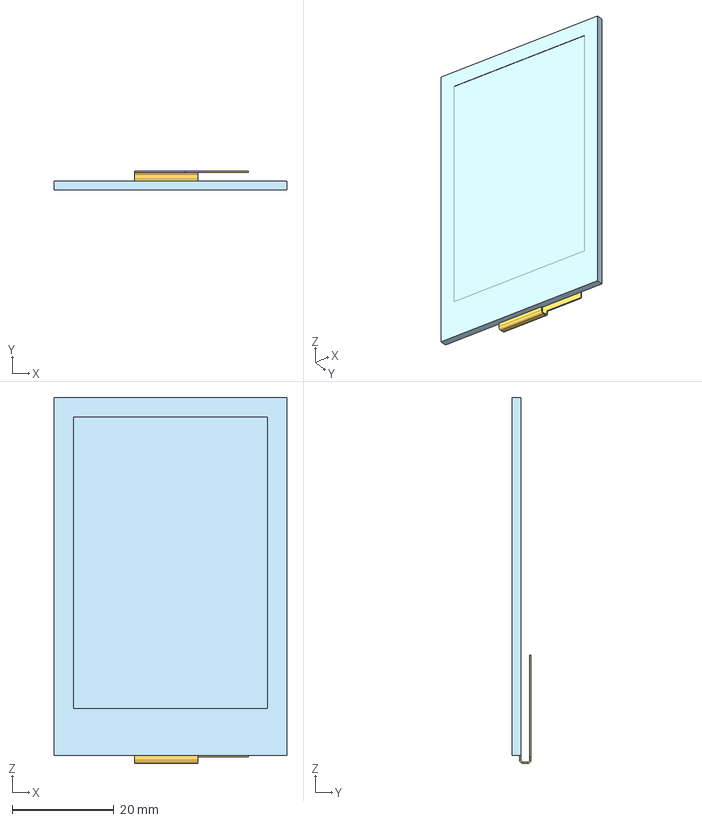
[picture p49: CAD file, 2026-05-06]
lib_3d/Custom_Display/GDEY027T91.step
45.8 x 3.75 x 72.0 mm
