CoolNamesAllTaken/kicad-libs/lib_3d/Custom_Filter/Filter_SAW-6_3.8x3.8mm.stp

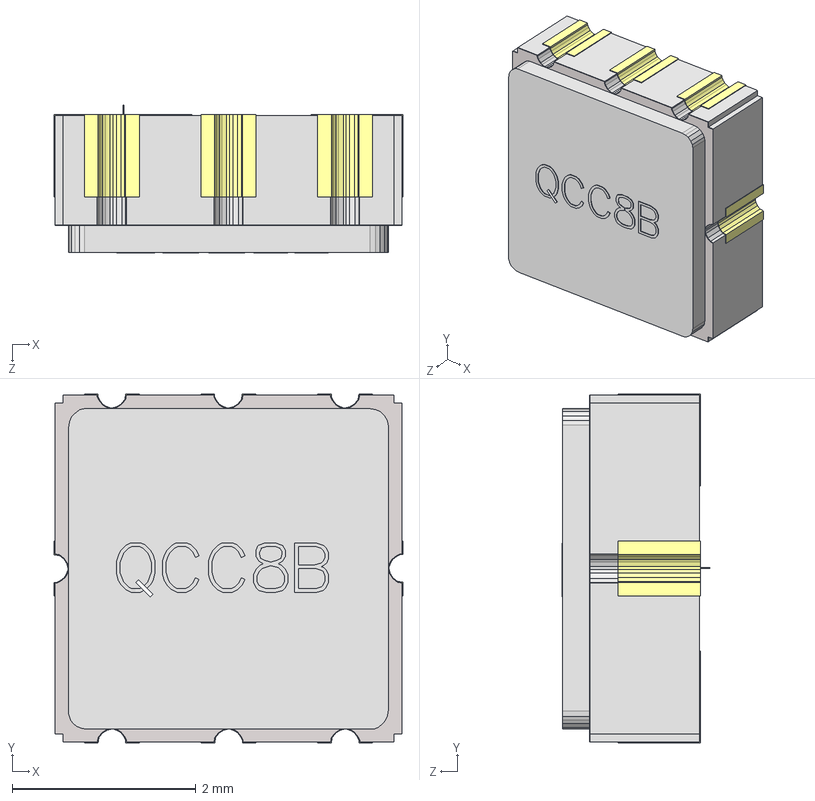
[picture p50: CAD file, 2023-06-24]
lib_3d/Custom_Filter/Filter_SAW-6_3.8x3.8mm.stp
3.80 x 3.80 x 1.62 mm
Board1
Extruded23
Extruded18 x 2
Extruded21
Extruded13
Extruded12
Extruded14
Extruded22
Extruded16
Extruded20 x 3
Extruded19 x 3
Extruded17
Extruded15
