CoolNamesAllTaken/kicad-libs/lib_3d/Custom_Fuse/31-8201.stp

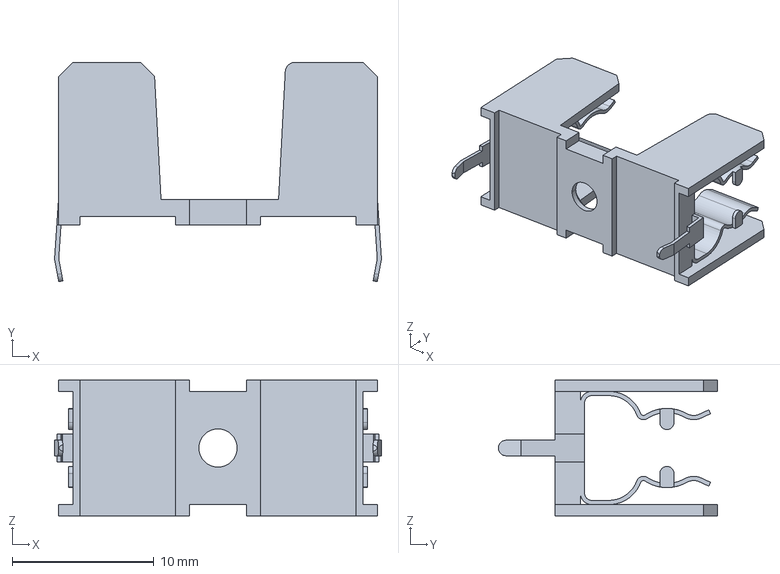
[picture p51: CAD file, 2023-06-24]
lib_3d/Custom_Fuse/31-8201.stp
23.1 x 15.5 x 9.60 mm
