CoolNamesAllTaken/kicad-libs/lib_3d/Custom_Inductor/L_Bourns_SRP7028A_7.3x6.6mm.stp

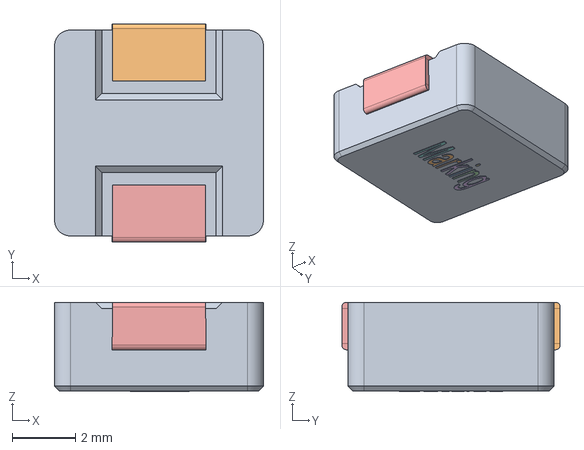
[picture p52: CAD file, 2023-06-24]
lib_3d/Custom_Inductor/L_Bourns_SRP7028A_7.3x6.6mm.stp
6.60 x 6.90 x 2.82 mm
