CoolNamesAllTaken/kicad-libs/lib_3d/Custom_LED_SMD/Led_Kingbright_APA2106.stp

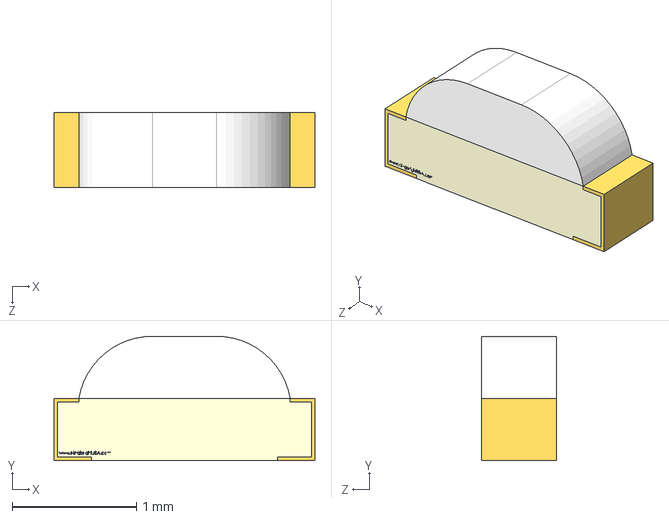
[picture p53: CAD file, 2023-06-24]
lib_3d/Custom_LED_SMD/Led_Kingbright_APA2106.stp
2.10 x 1.00 x 0.6 mm
