CoolNamesAllTaken/kicad-libs/lib_3d/Custom_Module/PA1616S.step

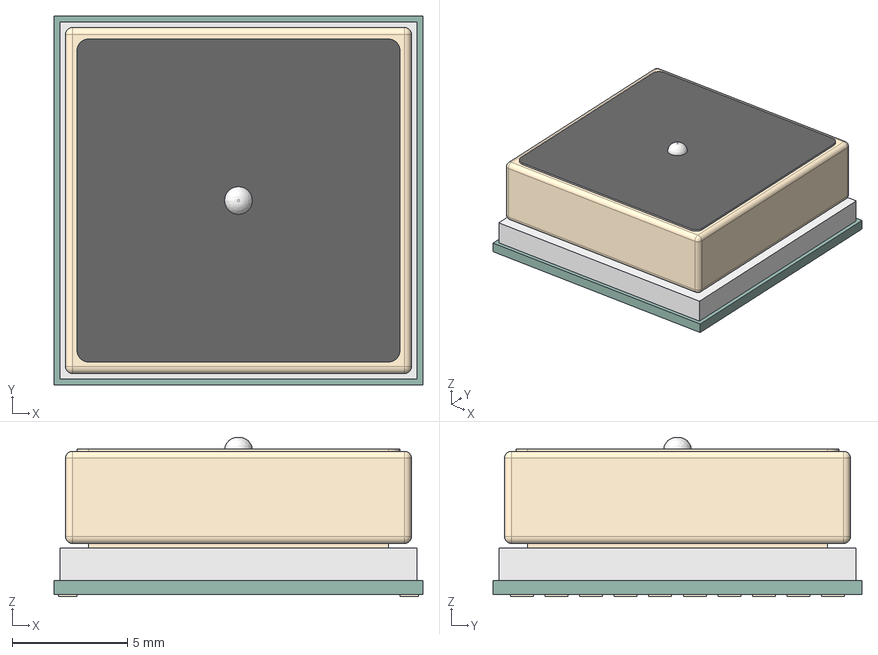
[picture p54: CAD file, 2023-06-24]
lib_3d/Custom_Module/PA1616S.step
16.0 x 16.0 x 6.90 mm
Antenna
Shield
PCB
Pads
