CoolNamesAllTaken/kicad-libs/lib_3d/Custom_OptoDevice/Everlight_ITR9608-F.stp

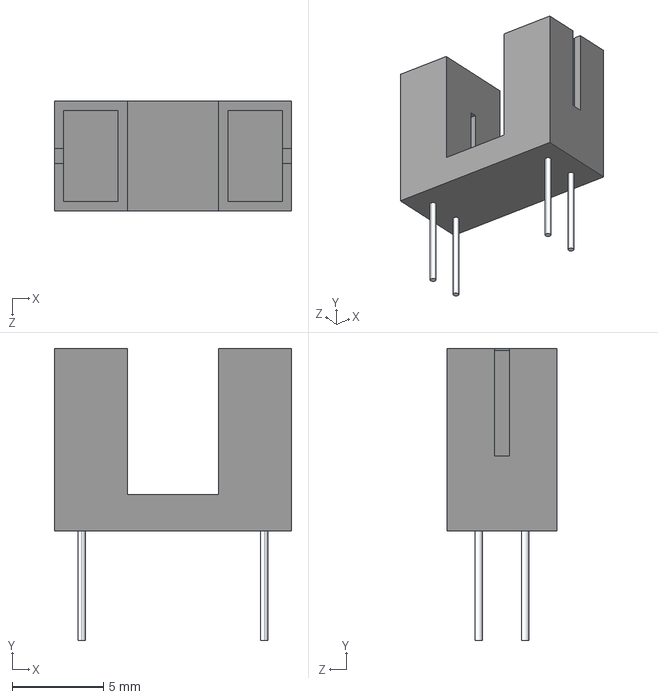
[picture p55: CAD file, 2023-07-08]
lib_3d/Custom_OptoDevice/Everlight_ITR9608-F.stp
13.0 x 16.0 x 6.00 mm
