CoolNamesAllTaken/kicad-libs/lib_3d/Custom_Package_DFN_QFN/XDFN8_1P6X1P2_ONS.step

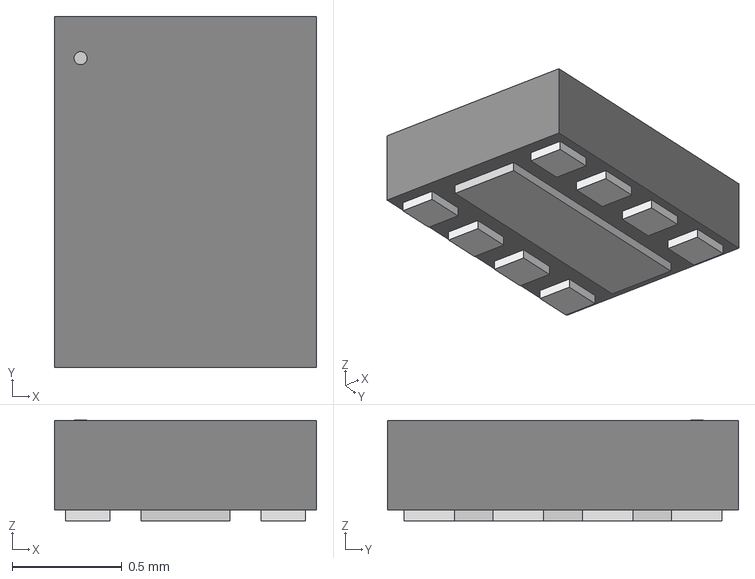
[picture p56: CAD file, 2026-04-22]
lib_3d/Custom_Package_DFN_QFN/XDFN8_1P6X1P2_ONS.step
1.19 x 1.60 x 0.46 mm
