CoolNamesAllTaken/kicad-libs/lib_3d/Custom_Package_SO/SOP-8_3.76x4.96mm_P1.27mm.step

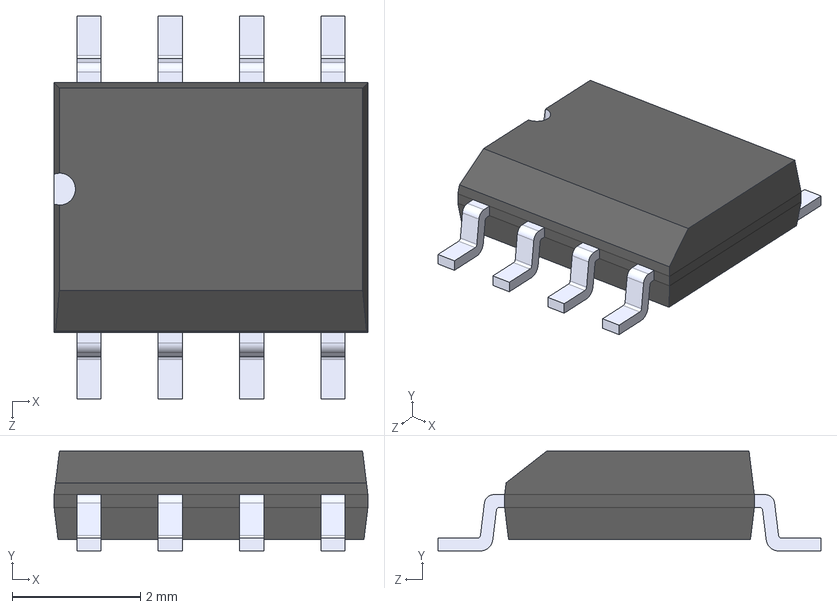
[picture p57: CAD file, 2022-11-25]
lib_3d/Custom_Package_SO/SOP-8_3.76x4.96mm_P1.27mm.step
4.90 x 1.56 x 5.98 mm
User Library-sop8_model_pin5to8_sop8 x 8
User Library-sop8_model_sop8_body
