CoolNamesAllTaken/kicad-libs/lib_3d/Custom_RF_Shielding/PantsForBIrds_PFB148-20C.step

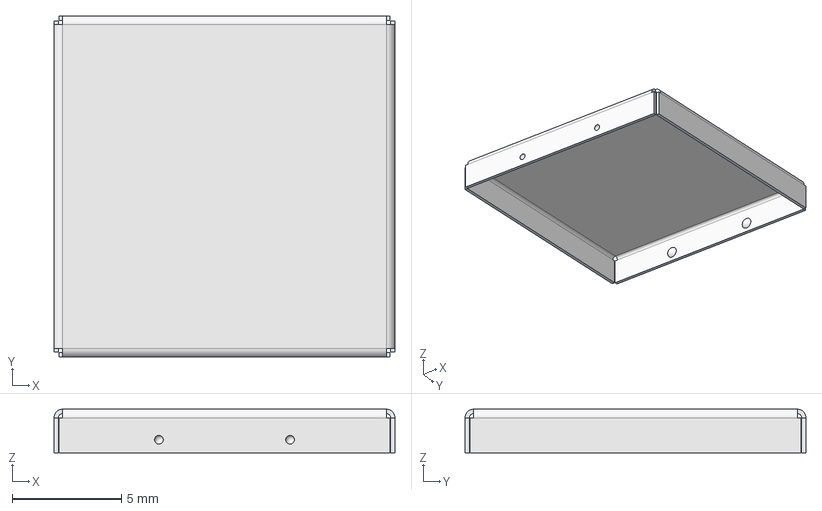
[picture p58: CAD file, 2025-03-28]
lib_3d/Custom_RF_Shielding/PantsForBIrds_PFB148-20C.step
15.6 x 15.6 x 2.00 mm
