CoolNamesAllTaken/kicad-libs/lib_3d/Custom_TestJack/Murata_MM8930-2620.step

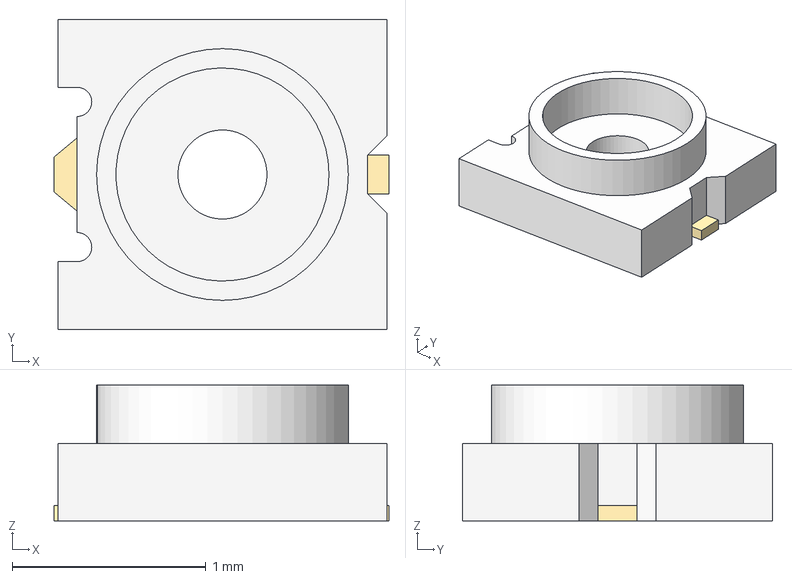
[picture p59: CAD file, 2025-01-05]
lib_3d/Custom_TestJack/Murata_MM8930-2620.step
1.73 x 1.60 x 0.7 mm
