CoolNamesAllTaken/kicad-libs/lib_3d/Custom_Transformer_SMD/Bourns_SM43P01EL.stp

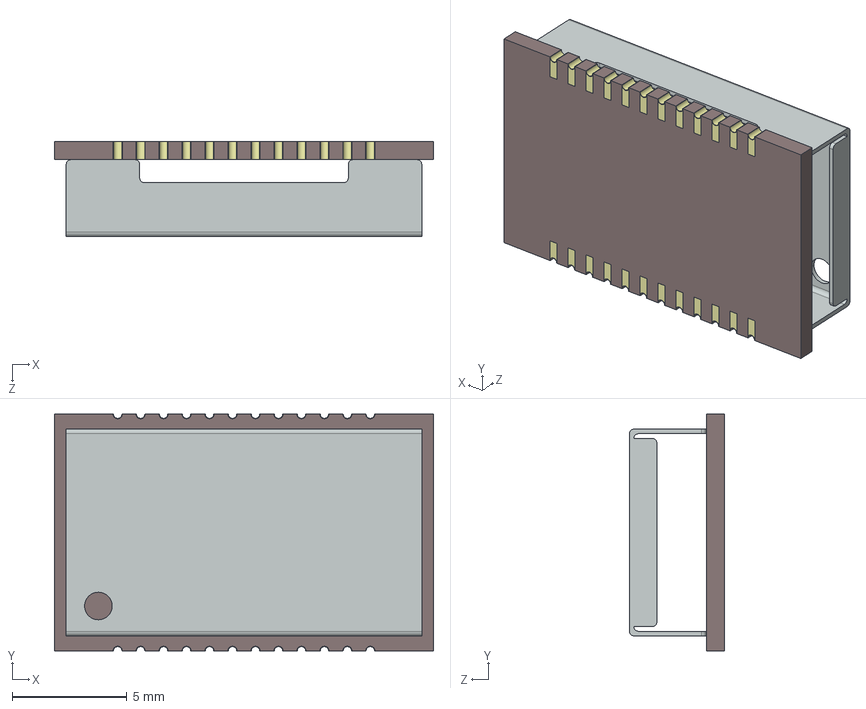
[picture p60: CAD file, 2023-06-24]
lib_3d/Custom_Transformer_SMD/Bourns_SM43P01EL.stp
16.5 x 10.3 x 4.15 mm
