CoolNamesAllTaken/kicad-libs/lib_3d/Custom_Connector_FFC-FPC/Hirose_FH34SRJ-24S-0.5SH_1x24-1MP_P0.50mm_Horizontal.stp

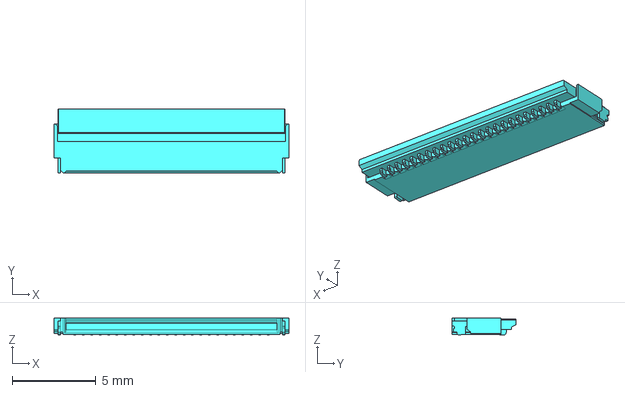
[picture p61: CAD file, 2023-06-24]
lib_3d/Custom_Connector_FFC-FPC/Hirose_FH34SRJ-24S-0.5SH_1x24-1MP_P0.50mm_Horizontal.stp
14.0 x 3.80 x 1.00 mm
