CoolNamesAllTaken/kicad-libs/lib_3d/Custom_Connector_JST/JST_SH_BM08B-SRSS-TB_1x08-1MP_P1.00mm_Vertical.step

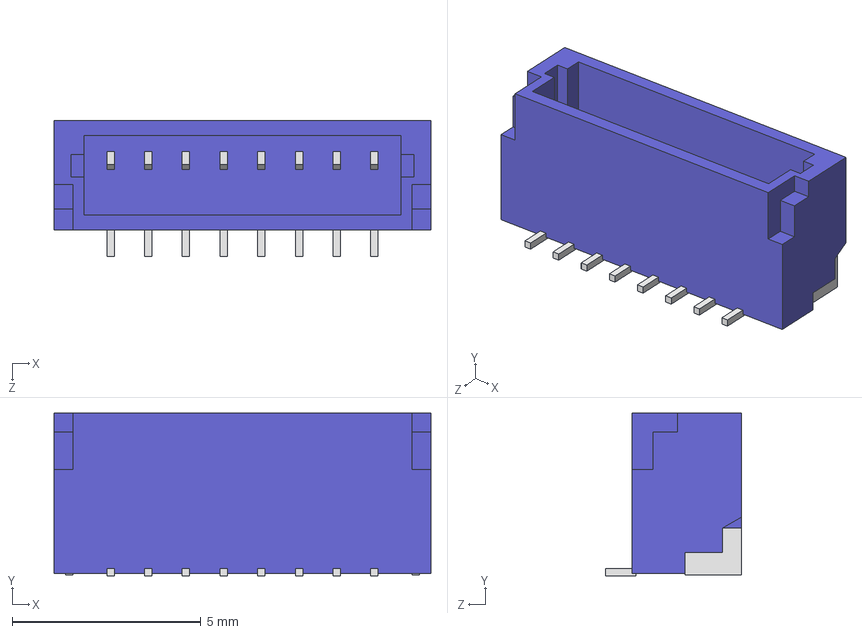
[picture p62: CAD file, 2024-08-17]
lib_3d/Custom_Connector_JST/JST_SH_BM08B-SRSS-TB_1x08-1MP_P1.00mm_Vertical.step
10.0 x 4.32 x 3.60 mm
