CoolNamesAllTaken/kicad-libs/lib_3d/Custom_Diode/D_0402_1005Metric.step

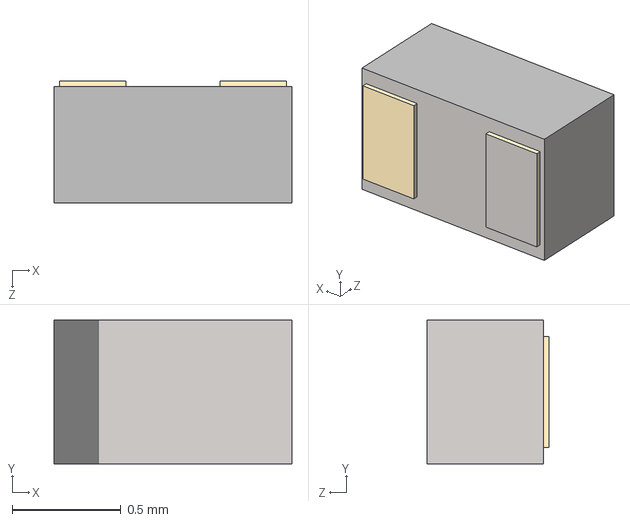
[picture p63: CAD file, 2023-06-24]
lib_3d/Custom_Diode/D_0402_1005Metric.step
1.09 x 0.66 x 0.559 mm
