CoolNamesAllTaken/kicad-libs/lib_3d/Custom_Diode_TVS/LLP75-7L.stp

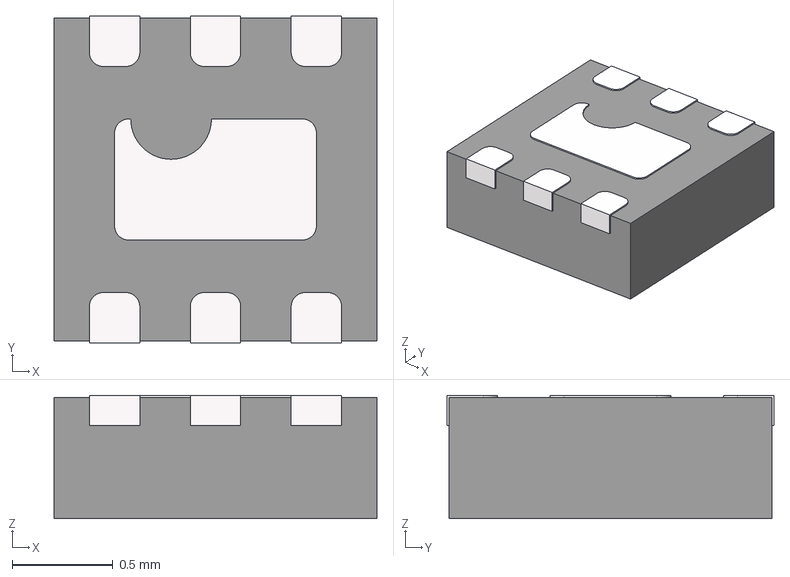
[picture p64: CAD file, 2023-06-24]
lib_3d/Custom_Diode_TVS/LLP75-7L.stp
1.60 x 1.62 x 0.611 mm
