CoolNamesAllTaken/kicad-libs/lib_3d/Custom_Inductor/IHLP6767GZER101M11.stp

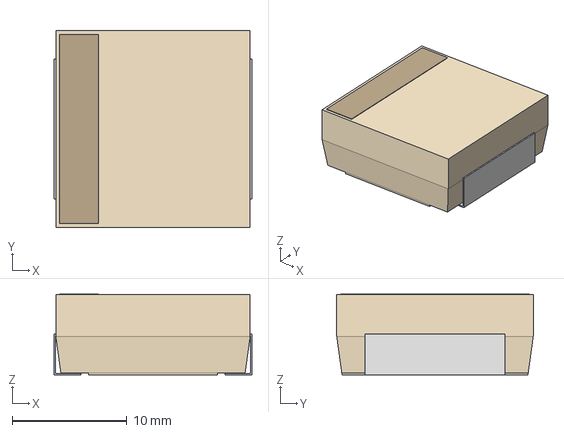
[picture p66: CAD file, 2023-06-24]
lib_3d/Custom_Inductor/IHLP6767GZER101M11.stp
17.3 x 17.1 x 7.06 mm
