CoolNamesAllTaken/kicad-libs/lib_3d/Custom_Package_DFN_QFN/Diodes_X2-DFN1210-8.step

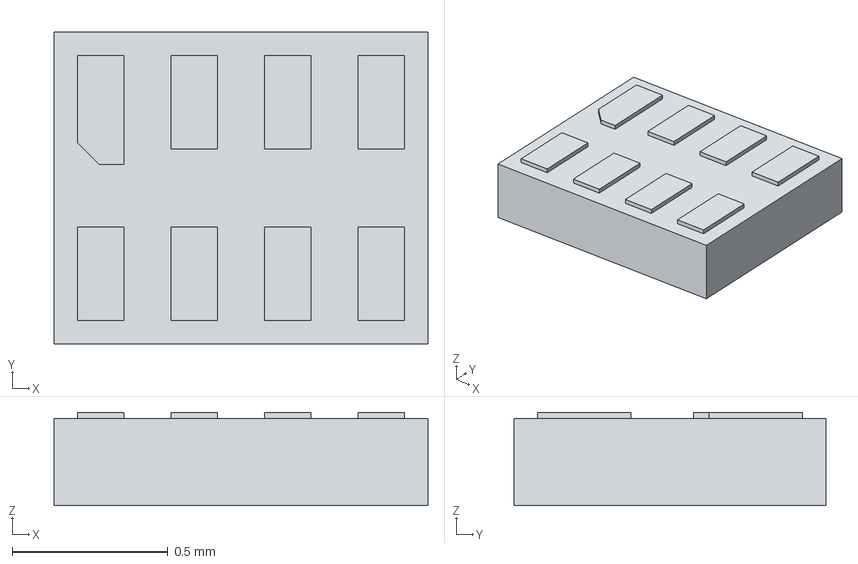
[picture p68: CAD file, 2026-04-22]
lib_3d/Custom_Package_DFN_QFN/Diodes_X2-DFN1210-8.step
1.20 x 1.00 x 0.3 mm
