CoolNamesAllTaken/kicad-libs/lib_3d/Custom_RF_Shielding/PantsForBirds_PFB148-20F.step

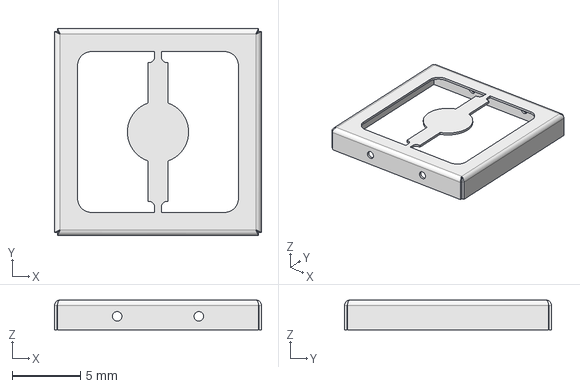
[picture p69: CAD file, 2025-03-28]
lib_3d/Custom_RF_Shielding/PantsForBirds_PFB148-20F.step
15.2 x 15.2 x 2.20 mm
