CoolNamesAllTaken/kicad-libs/lib_3d/Custom_Transformer_SMD/Pulse_HX0068ANL.stp

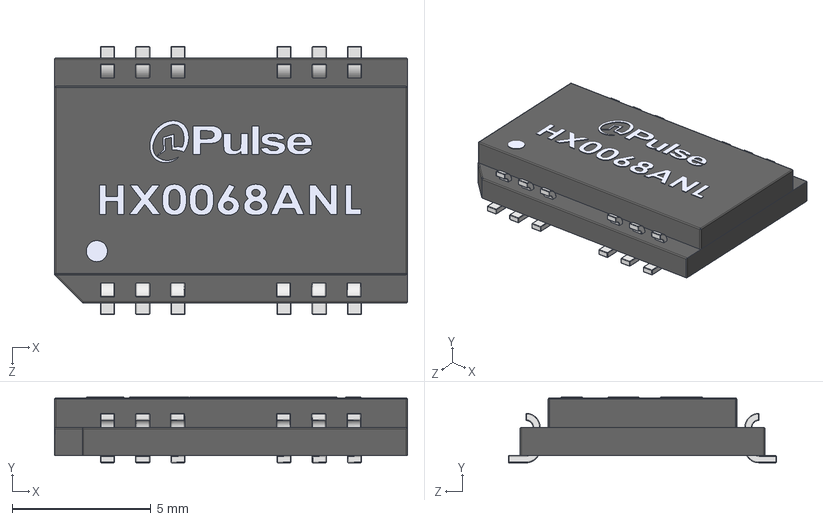
[picture p70: CAD file, 2023-06-24]
lib_3d/Custom_Transformer_SMD/Pulse_HX0068ANL.stp
12.7 x 2.37 x 9.65 mm
User Library-HX0068ANL_Pin x 12
User Library-HX0068ANL_Cap2
User Library-HX0068ANL_Cap1
