CoolNamesAllTaken/kicad-libs/lib_3d/Custom_Inductor/L_Taiyo-Yuden_NR-80xx.stp

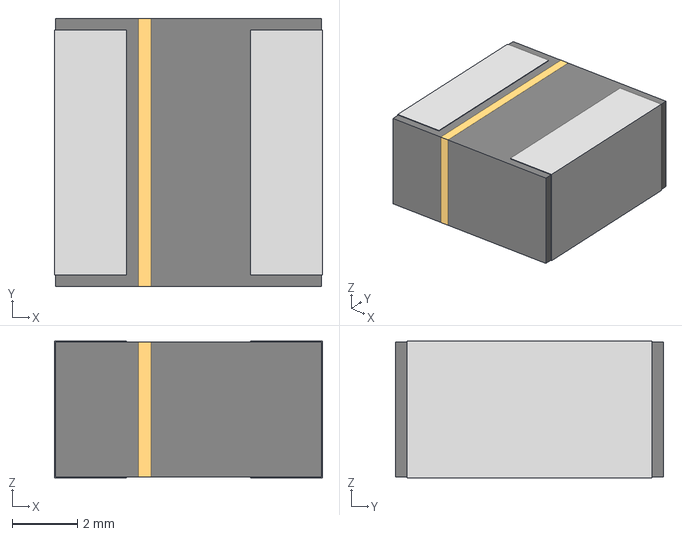
[picture p71: CAD file, 2023-06-24]
lib_3d/Custom_Inductor/L_Taiyo-Yuden_NR-80xx.stp
8.20 x 8.21 x 4.19 mm
