CoolNamesAllTaken/kicad-libs/lib_3d/Custom_Module/Amazon_Small_Buck.step

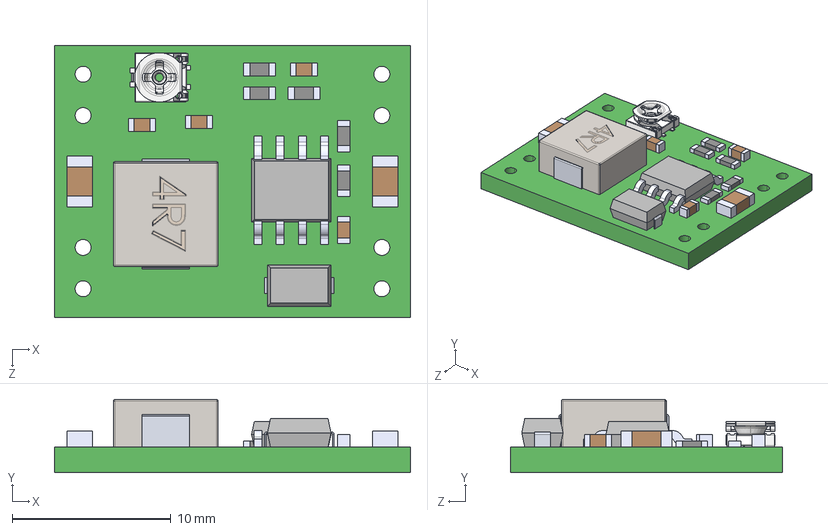
[picture p72: CAD file, 2022-11-25]
lib_3d/Custom_Module/Amazon_Small_Buck.step
22.4 x 4.60 x 17.1 mm
PCB, DC-DC 4.5-28V to 0.8-20V Output 3A MP1584EN Step Down Buck Converter
MP1584EN CHIP, DC-DC 4.5-28V to 0.8-20V Output 3A MP1584EN Step Down Buck Converter
INDUCTOR, DC-DC 4.5-28V to 0.8-20V Output 3A MP1584EN Step Down Buck Converter
SCHOTTKY DIODE, DC-DC 4.5-28V to 0.8-20V Output 3A MP1584EN Step Down Buck Converter
LARGE SMD CAPACITOR, DC-DC 4.5-28V to 0.8-20V Output 3A MP1584EN Step Down Buck Converter x 2
SMD RESISTOR, 104, DC-DC 4.5-28V to 0.8-20V Output 3A MP1584EN Step Down Buck Converter x 4
SMD RESISTOR, 822, DC-DC 4.5-28V to 0.8-20V Output 3A MP1584EN Step Down Buck Converter
SMALL SMD CAPACITOR, DC-DC 4.5-28V to 0.8-20V Output 3A MP1584EN Step Down Buck Converter x 4
POTENTIOMETER, DC-DC 4.5-28V to 0.8-20V Output 3A MP1584EN Step Down Buck Converter
