CoolNamesAllTaken/kicad-libs/lib_3d/Custom_Package_DFN_QFN/SENSOR_AHT20_GAE.step

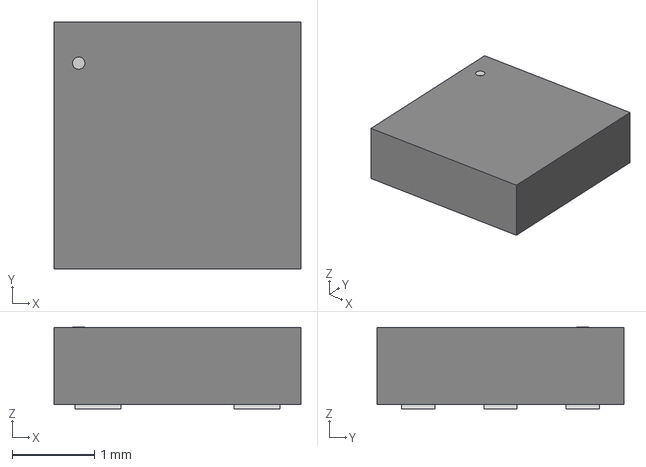
[picture p73: CAD file, 2026-04-22]
lib_3d/Custom_Package_DFN_QFN/SENSOR_AHT20_GAE.step
3.00 x 3.00 x 0.993 mm
