CoolNamesAllTaken/kicad-libs/lib_3d/Custom_RF_Shielding/MasachTech_MS148-20.stp

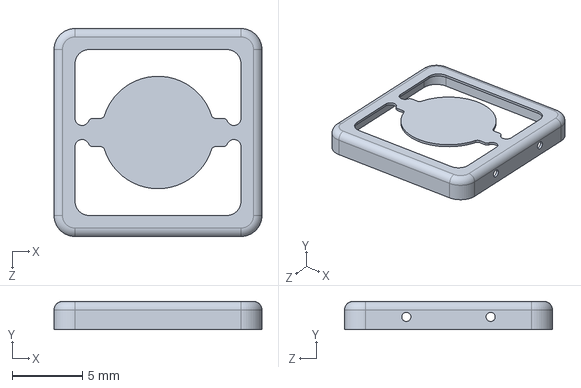
[picture p74: CAD file, 2025-03-24]
lib_3d/Custom_RF_Shielding/MasachTech_MS148-20.stp
14.8 x 2.00 x 14.8 mm
