CoolNamesAllTaken/kicad-libs/lib_3d/Custom_Transformer_SMD/Wuerth_750310744.stp

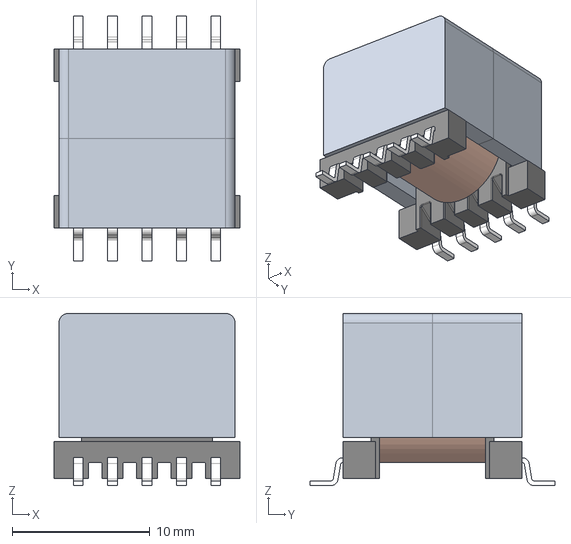
[picture p75: CAD file, 2023-06-24]
lib_3d/Custom_Transformer_SMD/Wuerth_750310744.stp
13.5 x 17.8 x 12.5 mm
