CoolNamesAllTaken/kicad-libs/lib_3d/Custom_Inductor/ASPI-0630LR.stp

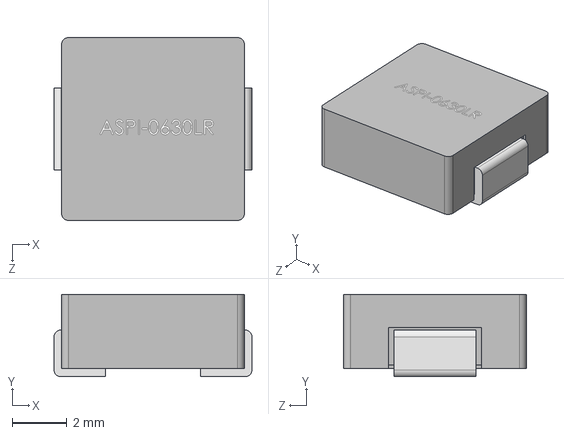
[picture p76: CAD file, 2023-06-24]
lib_3d/Custom_Inductor/ASPI-0630LR.stp
7.20 x 3.00 x 6.65 mm
