CoolNamesAllTaken/kicad-libs/lib_3d/Custom_Package_DFN_QFN/DFN3030-8_DIO.step

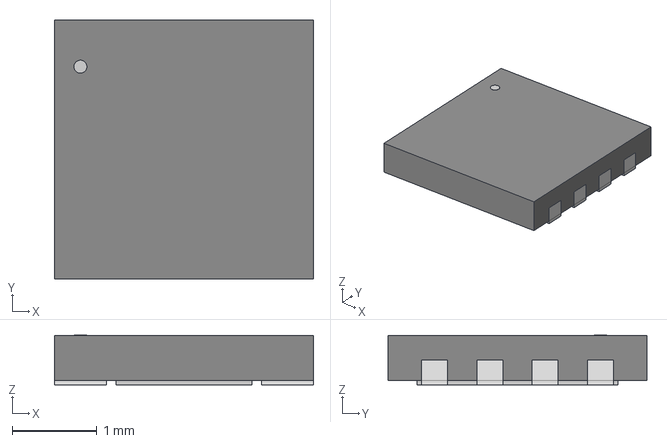
[picture p77: CAD file, 2026-04-22]
lib_3d/Custom_Package_DFN_QFN/DFN3030-8_DIO.step
3.05 x 3.05 x 0.587 mm
