CoolNamesAllTaken/kicad-libs/lib_3d/Custom_RF_Shielding/TE_Connectivity_2118716-2_2PC_Shield_16.50mmx16.50x3.60mm_SMD_Frame.stp

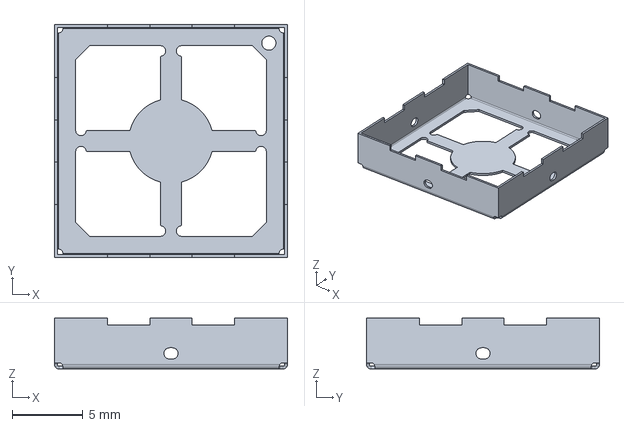
[picture p78: CAD file, 2024-08-17]
lib_3d/Custom_RF_Shielding/TE_Connectivity_2118716-2_2PC_Shield_16.50mmx16.50x3.60mm_SMD_Frame.stp
16.5 x 16.5 x 3.60 mm
