CoolNamesAllTaken/kicad-libs/lib_3d/Custom_Package_DFN_QFN/MP2720AGRH.step

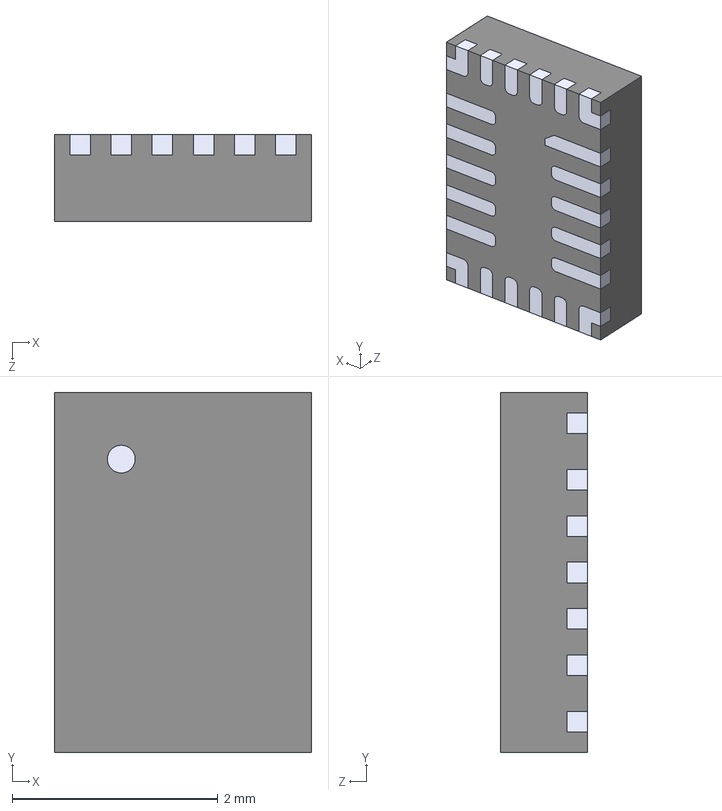
[picture p79: CAD file, 2026-04-22]
lib_3d/Custom_Package_DFN_QFN/MP2720AGRH.step
2.50 x 3.50 x 0.85 mm
