CoolNamesAllTaken/kicad-libs/lib_3d/Custom_RF_Shielding/TE_Connectivity_2118715-2_2PC_Shield_16.50mmx16.50x3.60mm_SMD_Cover.stp

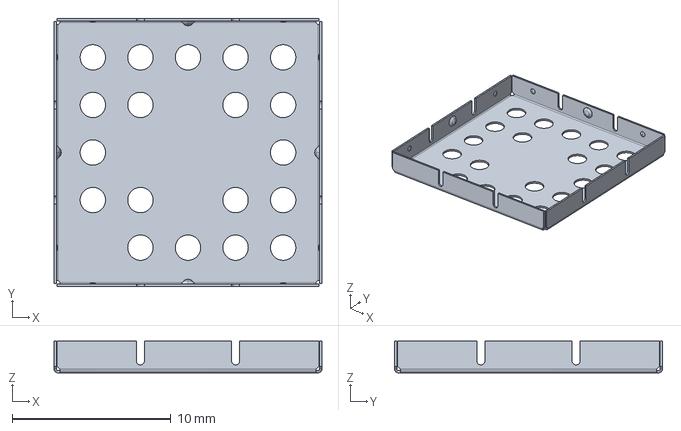
[picture p80: CAD file, 2024-08-17]
lib_3d/Custom_RF_Shielding/TE_Connectivity_2118715-2_2PC_Shield_16.50mmx16.50x3.60mm_SMD_Cover.stp
16.9 x 16.9 x 2.00 mm
