CoolNamesAllTaken/kicad-libs/lib_3d/Custom_RF_Shielding/TE_Connectivity_2118707-2_1PC_Shield_16.50mmx16.50x3.60mm_SMD.step

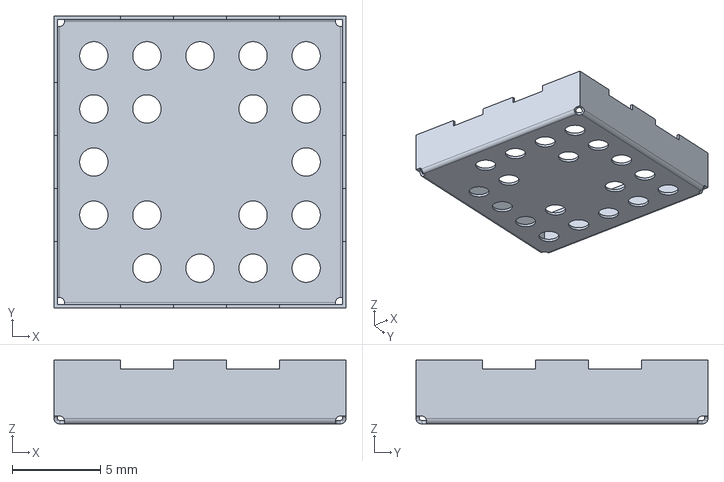
[picture p81: CAD file, 2024-07-10]
lib_3d/Custom_RF_Shielding/TE_Connectivity_2118707-2_1PC_Shield_16.50mmx16.50x3.60mm_SMD.step
16.5 x 16.5 x 3.60 mm
