CoolNamesAllTaken/kicad-libs/lib_3d/Custom_Package_DFN_QFN/RYK0018A.stp

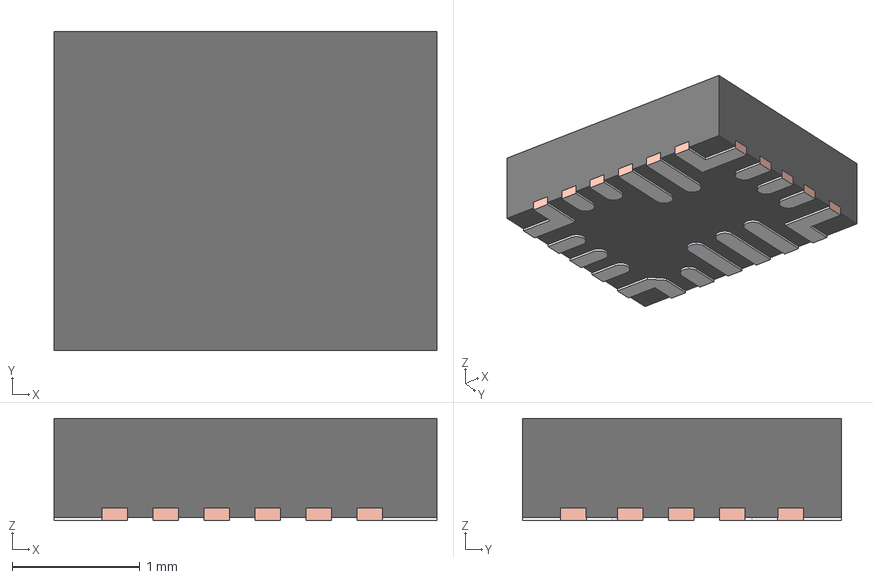
[picture p82: CAD file, 2026-04-22]
lib_3d/Custom_Package_DFN_QFN/RYK0018A.stp
3.00 x 2.50 x 0.8 mm
FRAME
MOLD
