CoolNamesAllTaken/kicad-libs/lib_3d/Custom_Package_DFN_QFN/VQFN-48-1EP_7x7mm_P0.5mm_EP5.15x5.15mm.step

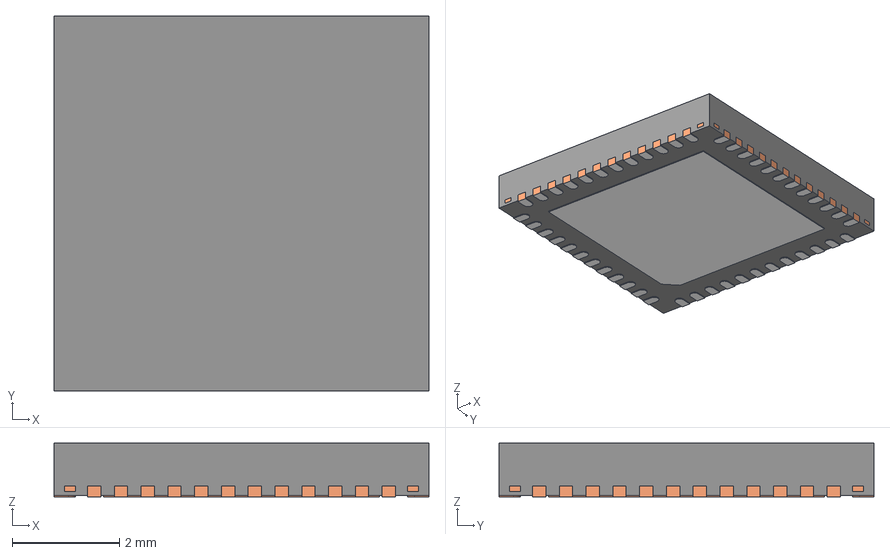
[picture p83: CAD file, 2025-05-04]
lib_3d/Custom_Package_DFN_QFN/VQFN-48-1EP_7x7mm_P0.5mm_EP5.15x5.15mm.step
7.00 x 7.00 x 1.00 mm
BODY-QFN
FRAME-RGZ0048A
PIN1-ID
