CoolNamesAllTaken/kicad-libs/lib_3d/Custom_Package_DFN_QFN/Diodes_DFN1006-3.step

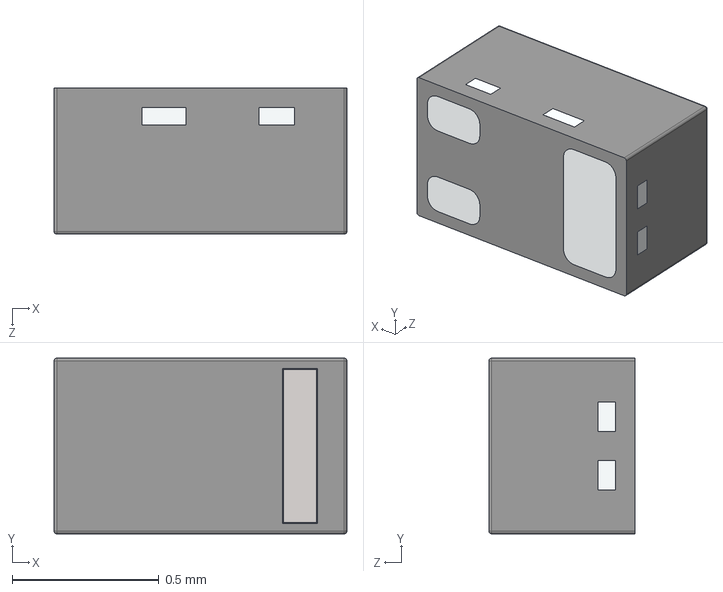
[picture p84: CAD file, 2024-08-17]
lib_3d/Custom_Package_DFN_QFN/Diodes_DFN1006-3.step
1.00 x 0.6 x 0.5 mm
