CoolNamesAllTaken/kicad-libs/(list of files, cad)

Other CAD files:
lib_3d/Custom_Connector_Card/1040310811.stp
lib_3d/Custom_Connector_Card/micro-sd-card-dummy.stl
lib_3d/Custom_RF_Antenna/1462350001.stp
lib_3d/Custom_ScrewTerminal/Wuerth_Redcube_74650073R_M3.stp
