CoolNamesAllTaken/kicad-libs/(commit log)

2020-02-26 Add stuff
    [PJ-320B.step]
2022-11-25 Import old stuff
    [Amazon_Small_Buck.step, Boom_PJ-320B.step, PJ-320B.step, RPi_Pico_SMD_TH.step, SOFNG_DC005-T20.step, SOP-8_3.76x4.96mm_P1.27mm.step]
2023-06-24 Add hecka symbols, footprints, and models
    [31-8201.stp, ASPI-0630LR.stp, Bourns_SM43P01EL.stp, D_0402_1005Metric.step, D_PowerDI-5.stp, ESD_TVS_0402_1005Metric.stp, Filter_SAW-6_3.8x3.8mm.stp, Filter_SAW-6_3.8x3.8mm_old.stp]
2023-07-08 New symbols
    [Everlight_ITR9608-F.stp, L_SunItechTech_SLO1040H470MTT.stp]
2023-11-26 Add new graphics and footprints
    [OLED_SSD1306_I2C.step, Pogo_P75-B1_SpearHead30deg_D1mm.stp, SOIC-8_5.23x5.23mm_P1.27mm.step]
2024-01-22 Add OpAmp library, add drawing templates, fix FPC connector
2024-07-10 New footprints and symbols
    [ESP32-S3-MINI-1U.step, Filter_SAW-6_3.0x3.0mm.step, Filter_SAW-6_3.8x3.8mm_old.stp, Hirose_DF40C-30DP-0.4V(51)_2x15_P0.40mm_Vertical.stp, Hirose_DF40C-30DP-0.4V(51)_2x15_P0.40mm_Vertical_PartOnly.stp, Hirose_DF40HC(3.5)-30DS-0.4V(51)_P0.4mm_Vertical.stp, Hirose_DF40HC(3.5)-30DS-0.4V(51)_P0.4mm_Vertical_PartOnly.stp, SOIC-8_5.23x5.23mm_P1.27mm.step]
2024-07-16 Update mounting holes and small button
    * Pull back copper flood from edges of mounting holes to avoid exposed
    copper.
    * Change small button 3D file from .wrl to STEP.
    [SW-SMD_L3.9-W2.9-H2.0-LS4.8.step]
2024-07-20 Add ADSBee footprints and transformer stuf
    [HanRun_HY931147C.step, RCH_RC01812.step, XFMR-SMD_H1102NLT.step]
2024-08-17 Add more RF connectors and RF shields.
    [Diodes_DFN1006-3.step, Hirose_U.FL-R-SMT-1.stp, Hirose_W.FL2-R-SMT-1.stp, JST_SH_BM03B-SRSS-TB_1x03-1MP_P1.00mm_Vertical.step, JST_SH_BM08B-SRSS-TB_1x08-1MP_P1.00mm_Vertical.step, TE_Connectivity_2118715-2_2PC_Shield_16.50mmx16.50x3.60mm_SMD_Cover.stp, TE_Connectivity_2118716-2_2PC_Shield_16.50mmx16.50x3.60mm_SMD_Frame.stp]
2025-01-05 Add RF testpoint connector and update DF40 courtyard
2025-01-05 Rename TestPoint library to TestJack to avoid issues with kibot
    * Move all the kibot scripts into kicad-libs/kibot
    [Keystone_5015_Micro-Minature.step, Murata_MM8930-2620.step]
2025-03-24 Update DF40 and EMI can footprints
    [MasachTech_MS148-20.stp]
2025-03-28 Add custom EMI shield model
    [PantsForBIrds_PFB148-20C.step, PantsForBirds_PFB148-20.step, PantsForBirds_PFB148-20F.step]
2025-03-31 Add footprints for ADSBee m1090
2025-04-03 Update Kibot and ADSBee m1090
    * Update ADSBee m1090 symbol and footprint with new ground pad near USB
    interface.
    * Update kibot for KiCAD 9.
2025-04-18 Fix kibot
    * Remove unused directories from run_kibot.bash.
    * Fix JLC BOM export so that non-JLC parts aren't excluded.
2025-05-01 Attempt grouping tiny silkscreen rev footprint
2025-05-04 Add custom crystals and update kibot config to stop using fancy stackup
    [Crystal_SMD_2016-4Pin_2.0x1.6mm.step, VQFN-48-1EP_7x7mm_P0.5mm_EP5.15x5.15mm.step]
2025-05-21 Update export script and PCB PN markings
2025-06-01 Update m1090 pogo footprint, exclude kitted parts from PCBs, and add custom reed switch
2025-06-03 Update footprints
2025-06-06 Update footprint fab attributes
2026-02-23 Update copypasta and footprints
2026-03-12 Remove comments from drawing export and improve diode silkscreen
2026-03-20 Commit new footprints
2026-03-31 Fix panelization issue by removing PCB DRC list
2026-03-31 Update export panel path and update m1421 footprints
2026-03-31 Fix BOM export
2026-04-01 Update export settings and add 3d model to m1421 footprint
2026-04-02 Improve export script and update module footprint and symbol
2026-04-05 Add mPCIe footprints and add assembly PDF to export script
2026-04-05 Fix U.FL footprint 3D model path
2026-04-05 Trigger exit on ERC or DRC fail. Update m1421 module and footprint.
2026-04-08 proto efb symbols, footprints, and models
    [1040310811.stp, 1462350001.stp, DFN3030-8_DIO.step, DSBGA9-YZF_TEX.step, Diodes_X2-DFN1210-8.step, FC-CO-5000.stp, GDEY027T91-FL02.step, Hirose_FH34SRJ-6S-0.5SH_1x6-1MP_P0.50mm_Horizontal.stp]
2026-04-13 Add new footprints and project template
    [impedance_control.xlsx, pantsforbirds_kicad_template.kicad_pcb, pantsforbirds_kicad_template.kicad_sch]
2026-04-13 preparing for export
    [LiPo 6060100.step, Membrane Button Rect 3.step]
2026-05-06 Add ePaper and update FFC libraries
    [FPC-SMD_5P-P0.50_HCTL_HC-FPC-05-10-5RLTAG.step, GDEY027T91.step]
2026-05-06 Fix PCBA rev number extraction for export
2026-05-08 renamed membrane keypad footprints to be more descriptive
2026-05-08 update 3d model path for fpc connector so that kipy export can find it
2026-06-26 supporting initial release of m1421 programmer
    [FTSH-105-01-L-DV-K.stp, SIBF-18-F-S-AB.stp]
