CoolNamesAllTaken/kicad-libs/(notices)

Notices in the files:
lib_3d/Custom_Connector/SIBF-18-F-S-AB.stp:
author */ ('License CC BY-ND 4.0'),
